peteattayek/PiTrac_V2/Hardware/firmware/START_HERE.md

# START HERE

Written for someone who has never built firmware for a Pico. No C knowledge
assumed. Follow it top to bottom; each step says what to expect so you can tell
whether it worked.

**Total time:** about 30–45 minutes for the first build, most of it downloads.

---

## What you're actually about to do

Four things, in order:

1. **Install a toolchain** — a compiler that turns `.c` files into a binary the
   RP2354 chip can run. Your PC's normal compiler makes Windows programs; this
   one makes ARM microcontroller programs.
2. **Build** — run the compiler. Produces `pitrac.uf2`, a single file.
3. **Flash** — copy that file onto the chip. The RP2354 has a trick where it
   pretends to be a USB memory stick, so "flashing" is literally drag-and-drop.
4. **Talk to it** — the firmware has a text menu over the USB cable. You open a
   terminal, type `stat`, and it answers.

Nothing here can damage the board. You're on USB power only, the +5 V rail is
off, and the firmware refuses to turn it on while running from USB.

---

## Step 1 — Install the toolchain

Use the VS Code extension. It downloads its own private copies of everything
into `C:\Users\<you>\.pico-sdk` and doesn't touch your system PATH, which on
Windows saves a great deal of pain.

1. Open **VS Code**.
2. Click the **Extensions** icon in the left sidebar (four little squares), or
   press `Ctrl+Shift+X`.
3. Search for **`Raspberry Pi Pico`**. Install the one published by
   **Raspberry Pi**. (Not "Pico-Go", not "Pymakr" — those are for MicroPython.)
4. After it installs, a small Raspberry Pi logo appears in the left sidebar.

> The extension downloads ~1–2 GB the first time it configures a project. That's
> normal and it only happens once.

---

## Step 2 — Open the project and let it configure

1. **File → Open Folder** → choose:
   ```
   C:\Users\ATTAYEKP\Github-Personal\PiTrac_V2\Hardware\firmware
   ```
   Open the **`firmware`** folder itself, not the folder above it. This matters —
   `CMakeLists.txt` has to be at the top level of what you open.

2. Press `Ctrl+Shift+P` to open the command palette (a text box at the top).
   Type **`Pico: Import Project`** and press Enter.

   > **⚠ It will look like it hangs. It hasn't.** The first thing this command
   > does is open a *native Windows folder picker*, and on Windows that dialog
   > very often opens **behind** the VS Code window. **Alt+Tab to find it.**
   > After the folder picker there is a second step: a **form in a new tab**
   > with an **Import button at the bottom that you have to scroll down to**.
   > Nothing downloads until you click it.

3. In that form:

   | Field | Choose |
   |---|---|
   | **ARM vs RISC-V** | **ARM.** Not negotiable — see below. |
   | **SDK version** | Newest offered, and it **must be ≥ 2.1**. Earlier SDKs don't know about the RP2354. |
   | **Board type** | Anything. `CMakeLists.txt` forces the real board and a compile-time assert catches any override. |
   | **Debugger** | Default is fine. Not used yet. |

   > **Why ARM matters:** the RP2350 die carries *both* dual Cortex-M33 (ARM)
   > and dual Hazard3 (RISC-V) cores, and the extension will cheerfully set you
   > up for RISC-V. All of this firmware assumes ARM, and the `.uf2` has to be
   > family `rp2350-arm-s`. Picking RISC-V produces confusing build failures.
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
