peteattayek/PiTrac_V2/Hardware/Calibration/index.html

# Camera distortion calibration

For each identified Mira220 / ND3630 stack at its final 850 nm filter, illumination and locked focus state.

Digital template validation is not physical calibration. Print at actual size / 100%, disable fit or shrink, and verify both 100 mm bars. Mount the target flat on rigid matte backing and check its actual infrared contrast.

## A4 landscape

297 x 210 mm page. Pattern: 220 x 160 mm.

Open printable A4 PDF | Open vector SVG

A4 ChArUco target with horizontal and vertical 100 mm scale checks

## US Letter landscape

279.4 x 215.9 mm page. Same physical pattern, not a resized A4 pattern.

Open printable Letter PDF | Open vector SVG

Letter ChArUco target with horizontal and vertical 100 mm scale checks

## Next steps

1. Read the entry guide and the calibration procedure.
2. Verify print dimensions, flatness and infrared contrast before filling a session record.
3. Copy the appropriate CAM0 or CAM1 session template to a new run directory.
4. Use the 30 fit / 10 validation pose checklist. Capture three distinct stationary frames per pose; keep repeat groups in the same split.
5. Preserve native 12-bit images and read the point-coordinate conventions.

Target identity: pitrac-charuco-11x8-20mm-v1, 11 x 8 squares, 20 mm square pitch, 15 mm markers, DICT_5X5_250, current (non-legacy) OpenCV 4.13 layout. Machine-readable board definition.

The images on this page are scaled for viewing. Measure the printed scale bars, not the screen. No camera coefficients, pupil coordinate, enclosure pose, physical accuracy, or production readiness are established by these files.
