peteattayek/PiTrac_V2/Hardware/Calibration/targets/charuco-a4.pdf

pitrac-charuco-11x8-20mm-v1 | 20 mm squares | 15 mm markers | PRINT 100%

100 mm X

100 mm Y
