peteattayek/PiTrac_V2/Hardware/Calibration/targets/board-raster.png

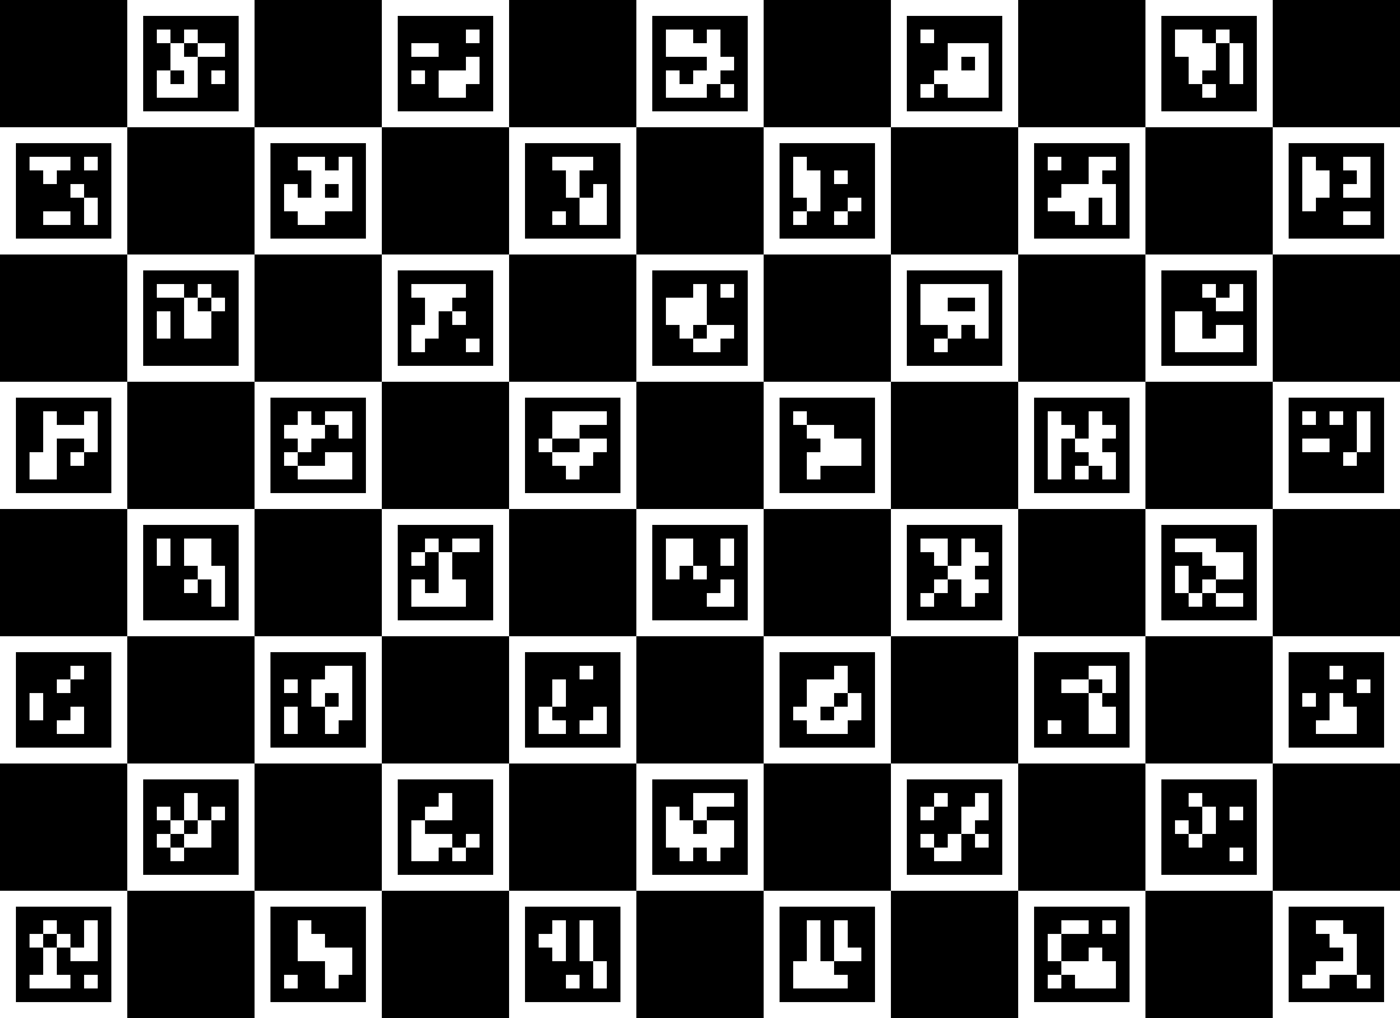
Hardware/Calibration/targets/board-raster.png
