peteattayek/PiTrac_V2/Hardware/The_Second_Board_To_Rule_Them_All/The_Second_Board_To_Rule_Them_All.pdf

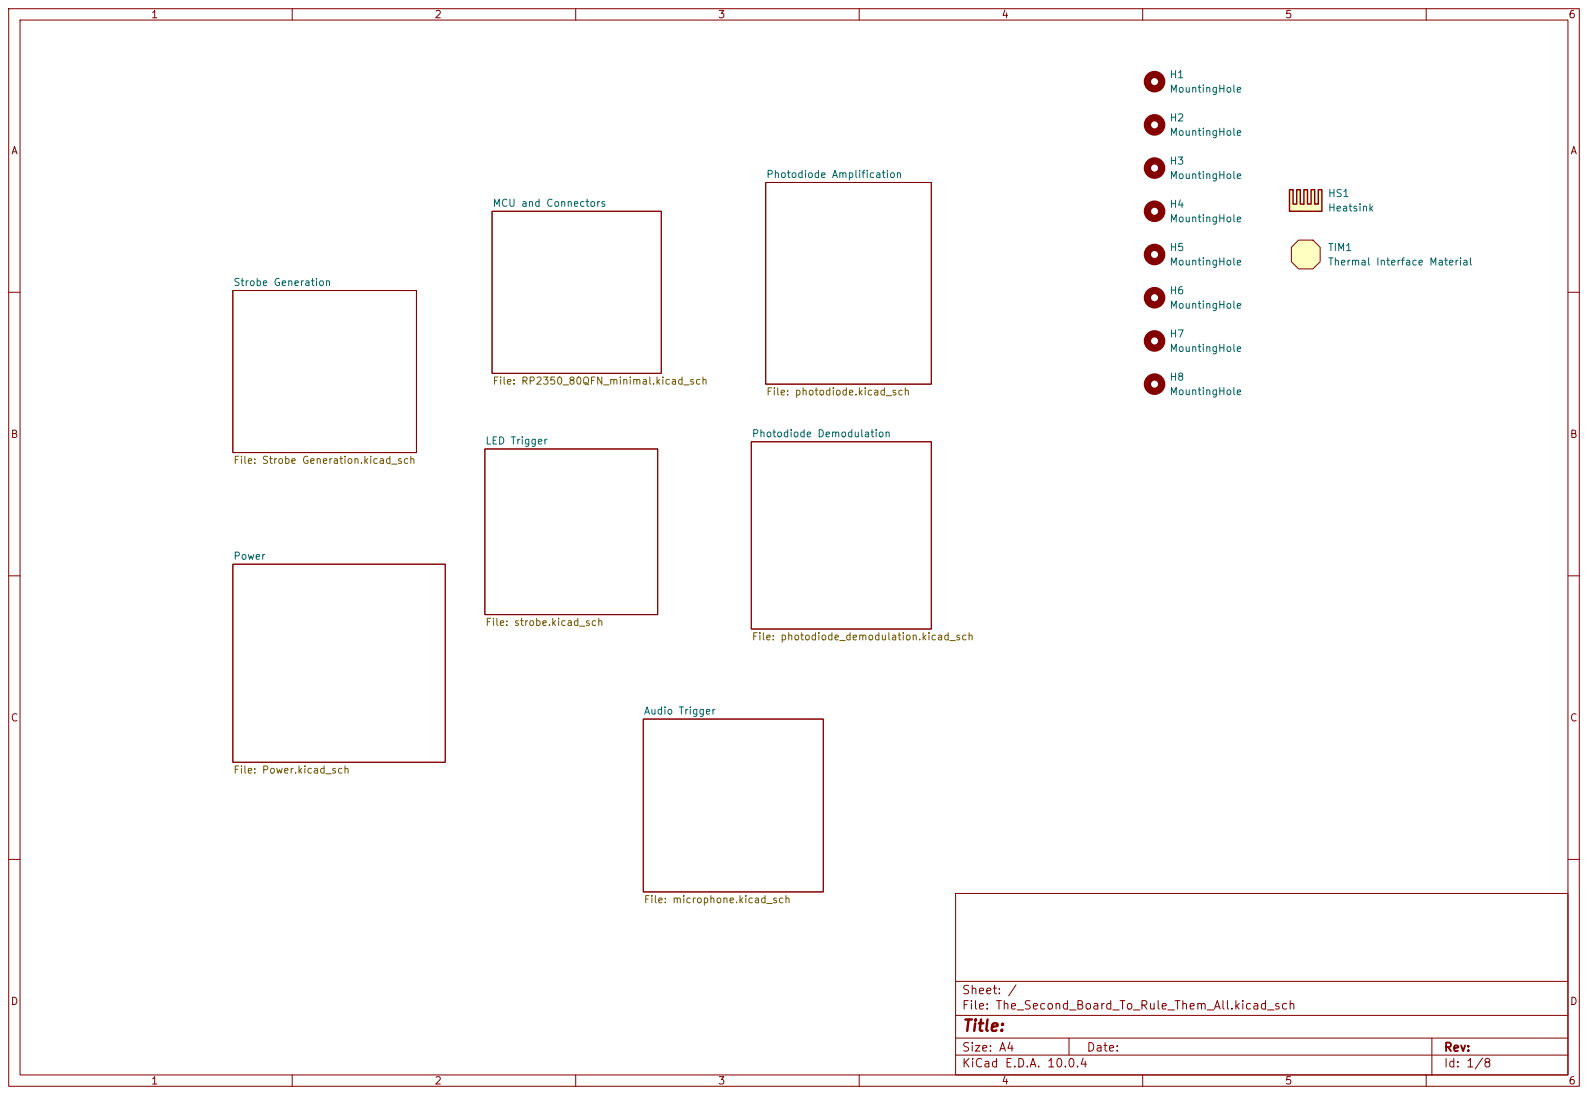
[picture p2: page 1]

Thermal Interface Material HS1 Heatsink H8MountingHole H7MountingHole H6MountingHole

LED Trigger File: strobe.kicad_sch Strobe Generation

Audio Trigger File: microphone.kicad_sch

Size: A4 | Rev:
KiCad E.D.A. 10.0.4 | Id: 1/8

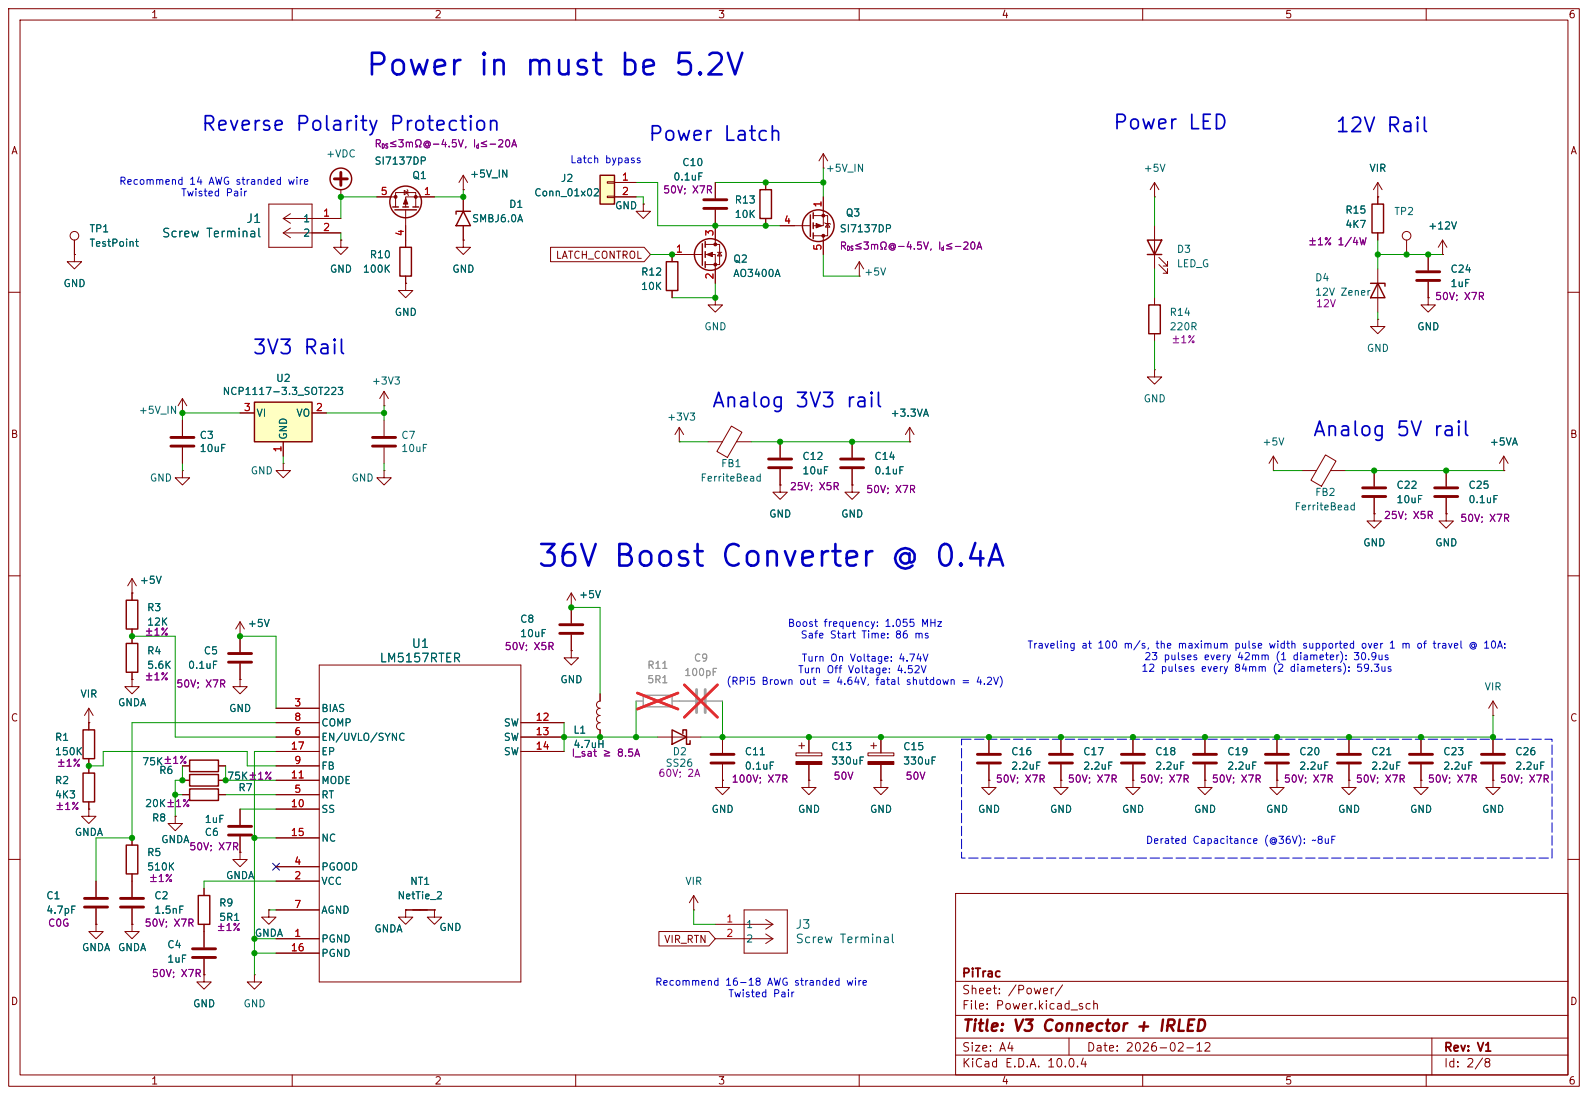
[picture p3: page 2]

J2 Conn_01x02 R3
Recommend 14 AWG stranded wire

Derated Capacitance (@36V): ~8uF Boost frequency: 1.055 MHz Safe Start Time: 86 ms

(RPi5 Brown out = 4.64V, fatal shutdown = 4.2V)

Recommend 16-18 AWG stranded wire

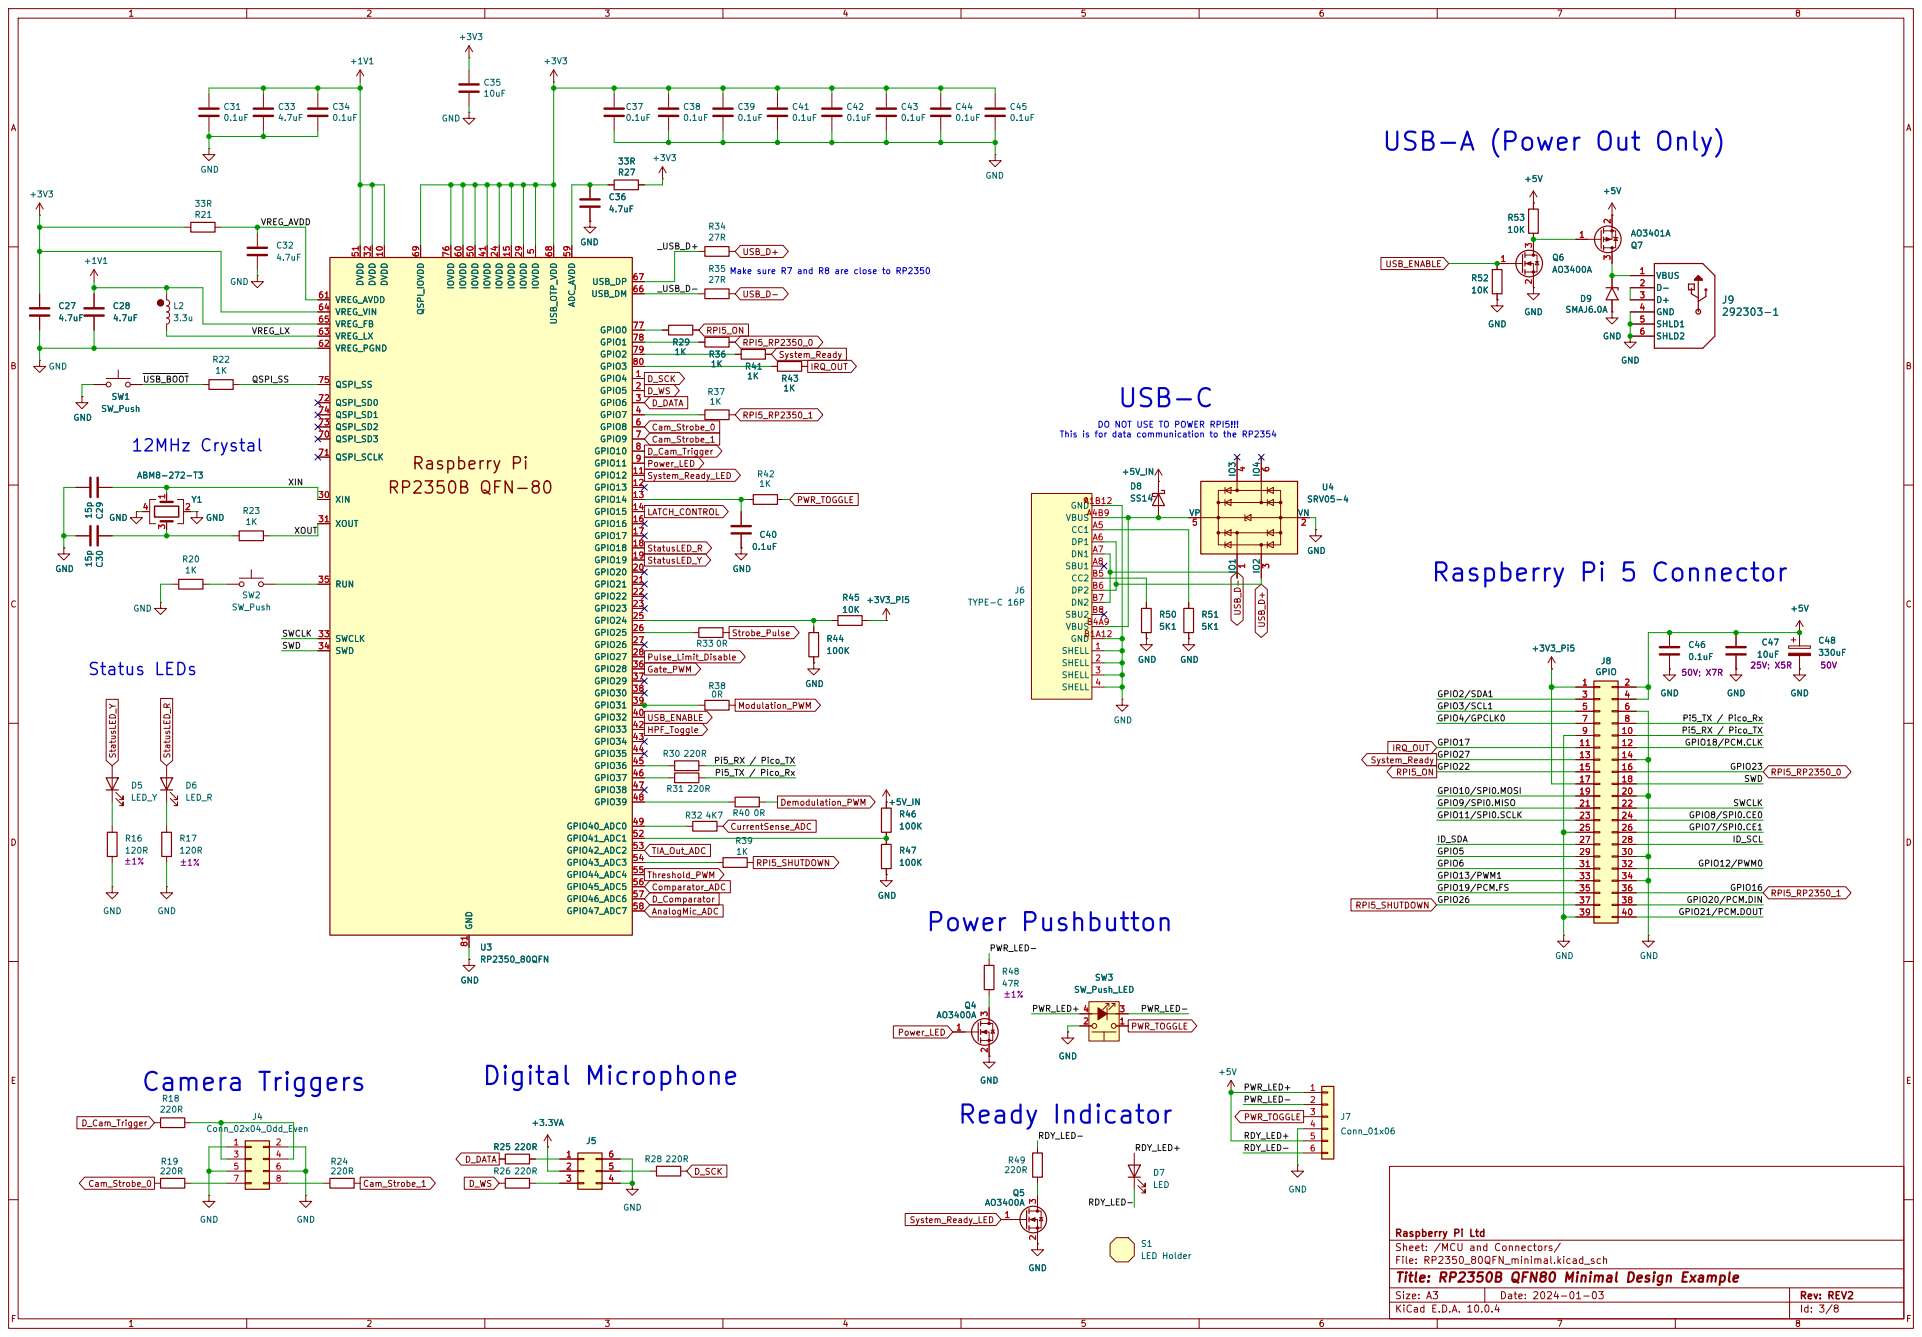
[picture p4: page 3]

USB-A (Power Out Only)

5 GPIO8 6 GPIO9 7 GPIO10 8 GPIO11 9 DVDD 10 GPIO12 11 GPIO13 12 GPIO14 13 GPIO15 14 IOVDD 15 GPIO16 16 GPIO17 17 GPIO18 18 GPIO19 19 GPIO20 20 GPIO21 21 GPIO22 22 GPIO23 23 IOVDD 24 GPIO24 25 GPIO25 26 GPIO26 27 GPIO27 28 IOVDD 29

Raspberry Pi Ltd
Sheet: /MCU and Connectors/
File: RP2350_80QFN_minimal.kicad_sch
Title: RP2350B QFN80 Minimal Design Example

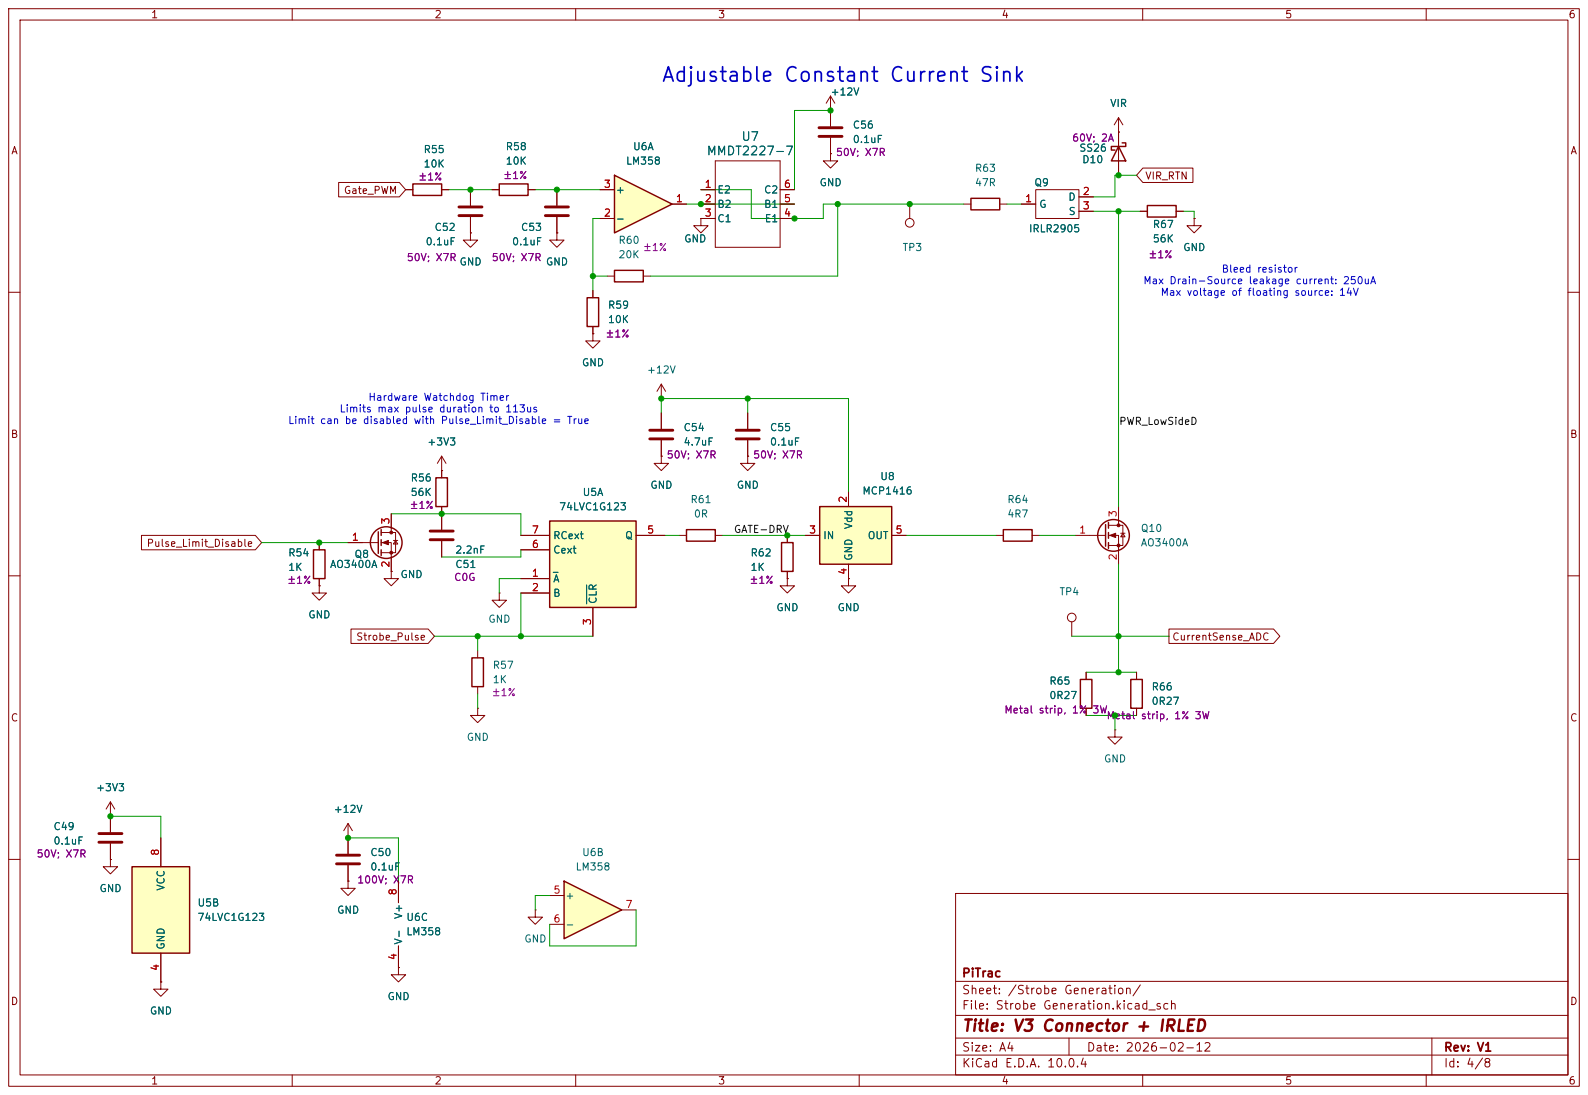
[picture p5: page 4]

GATE-DRV Adjustable Constant Current Sink

GND Q8 AO3400A 1
Bleed resistor Max Drain-Source leakage current: 250uA Max voltage of floating source: 14V Hardware Watchdog Timer Limits max pulse duration to 113us

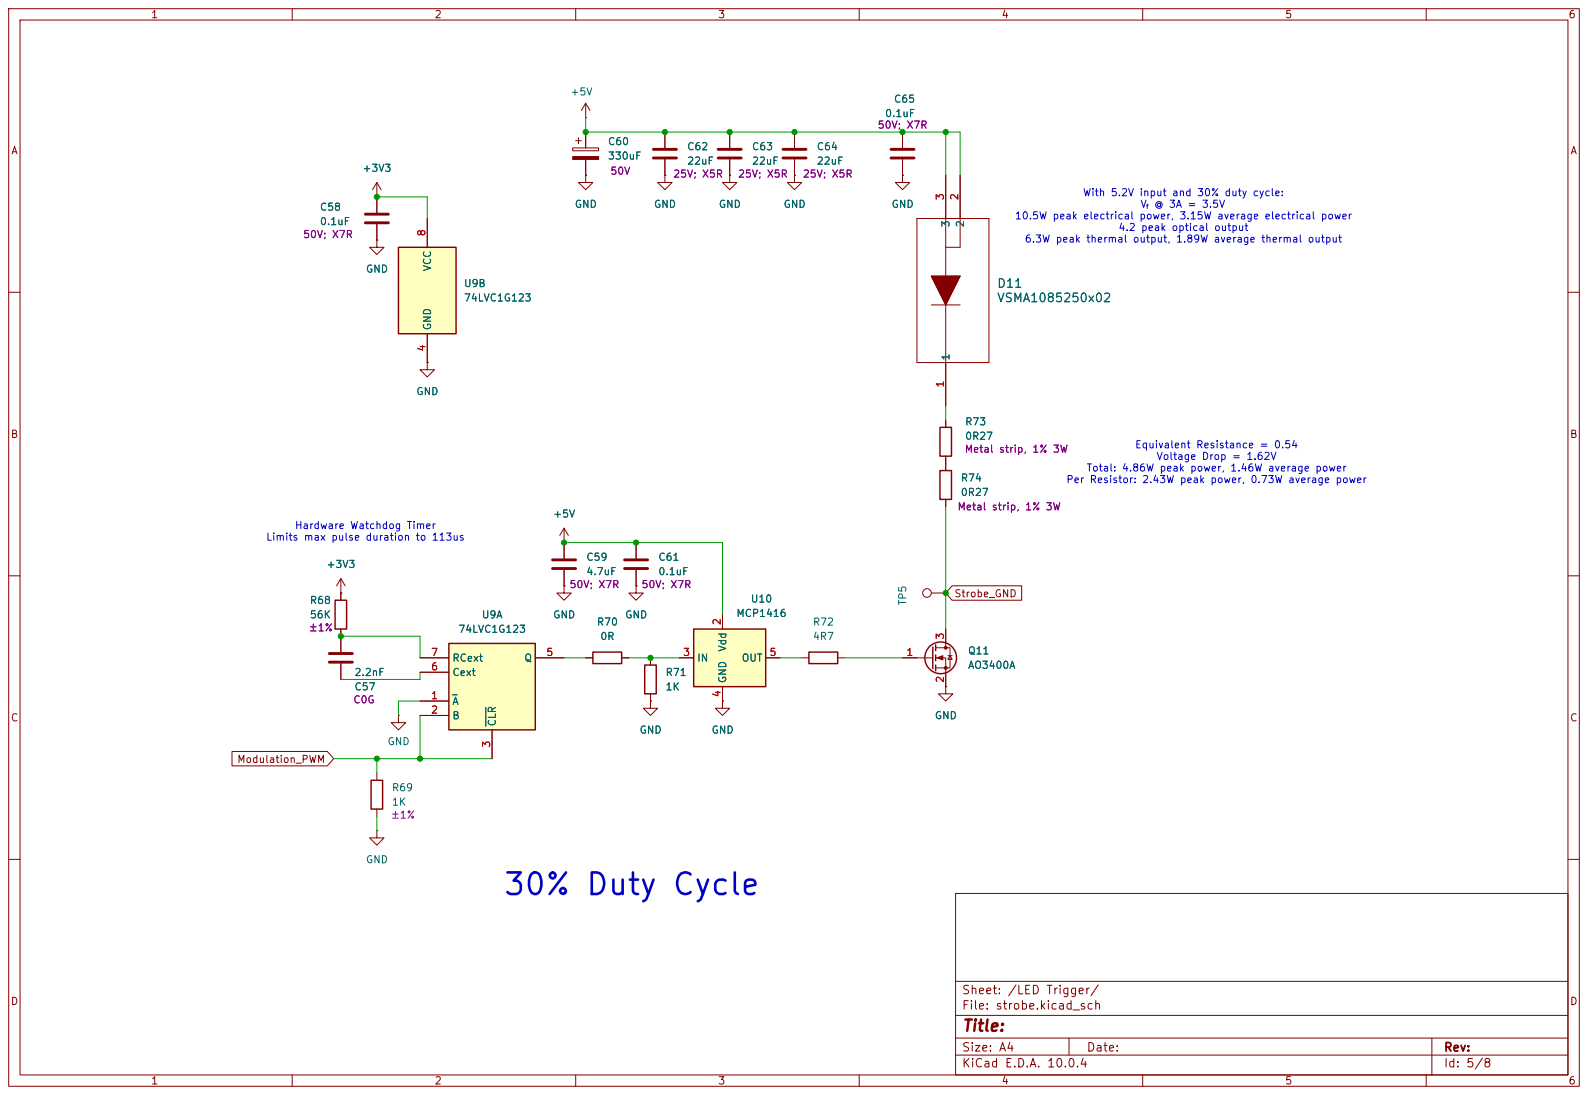
[picture p6: page 5]

Total: 4.86W peak power, 1.46W average power Per Resistor: 2.43W peak power, 0.73W average power C59

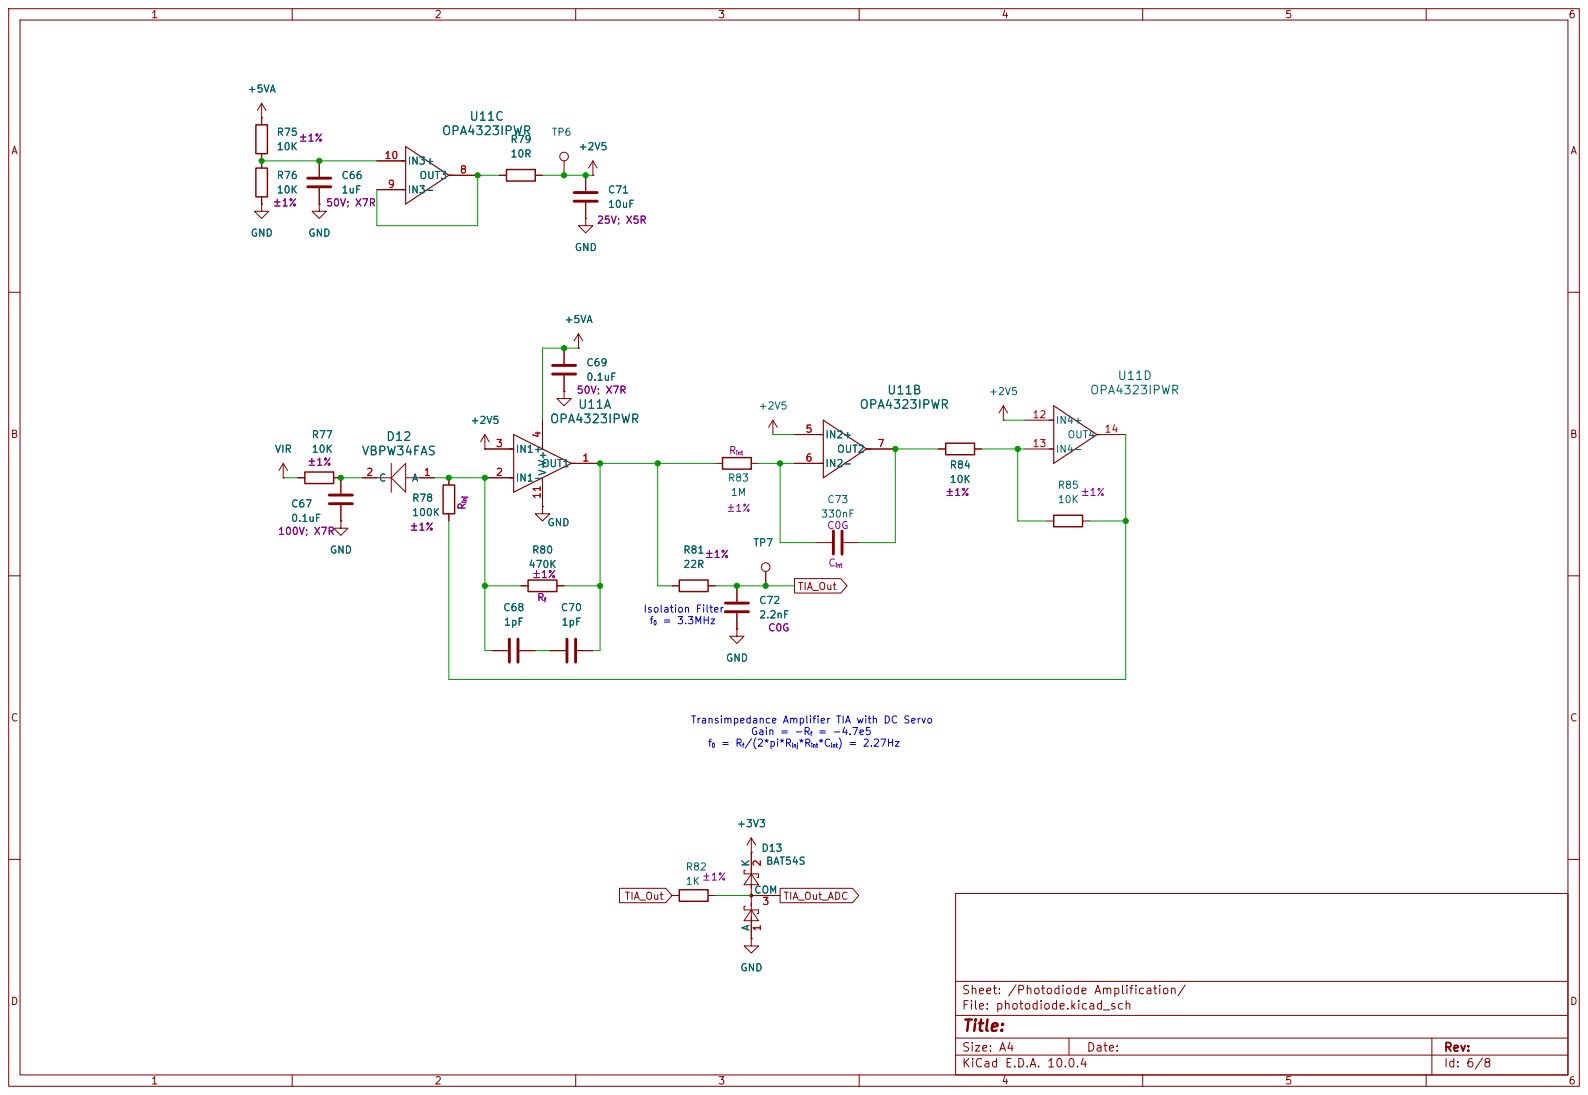
[picture p7: page 6]

f0 = Rf/(2*pi*Rinj*Rint*Cint) = 2.27Hz U11C
OPA4323IPWR R79

Transimpedance Amplifier TIA with DC Servo Gain = -Rf = -4.7e5

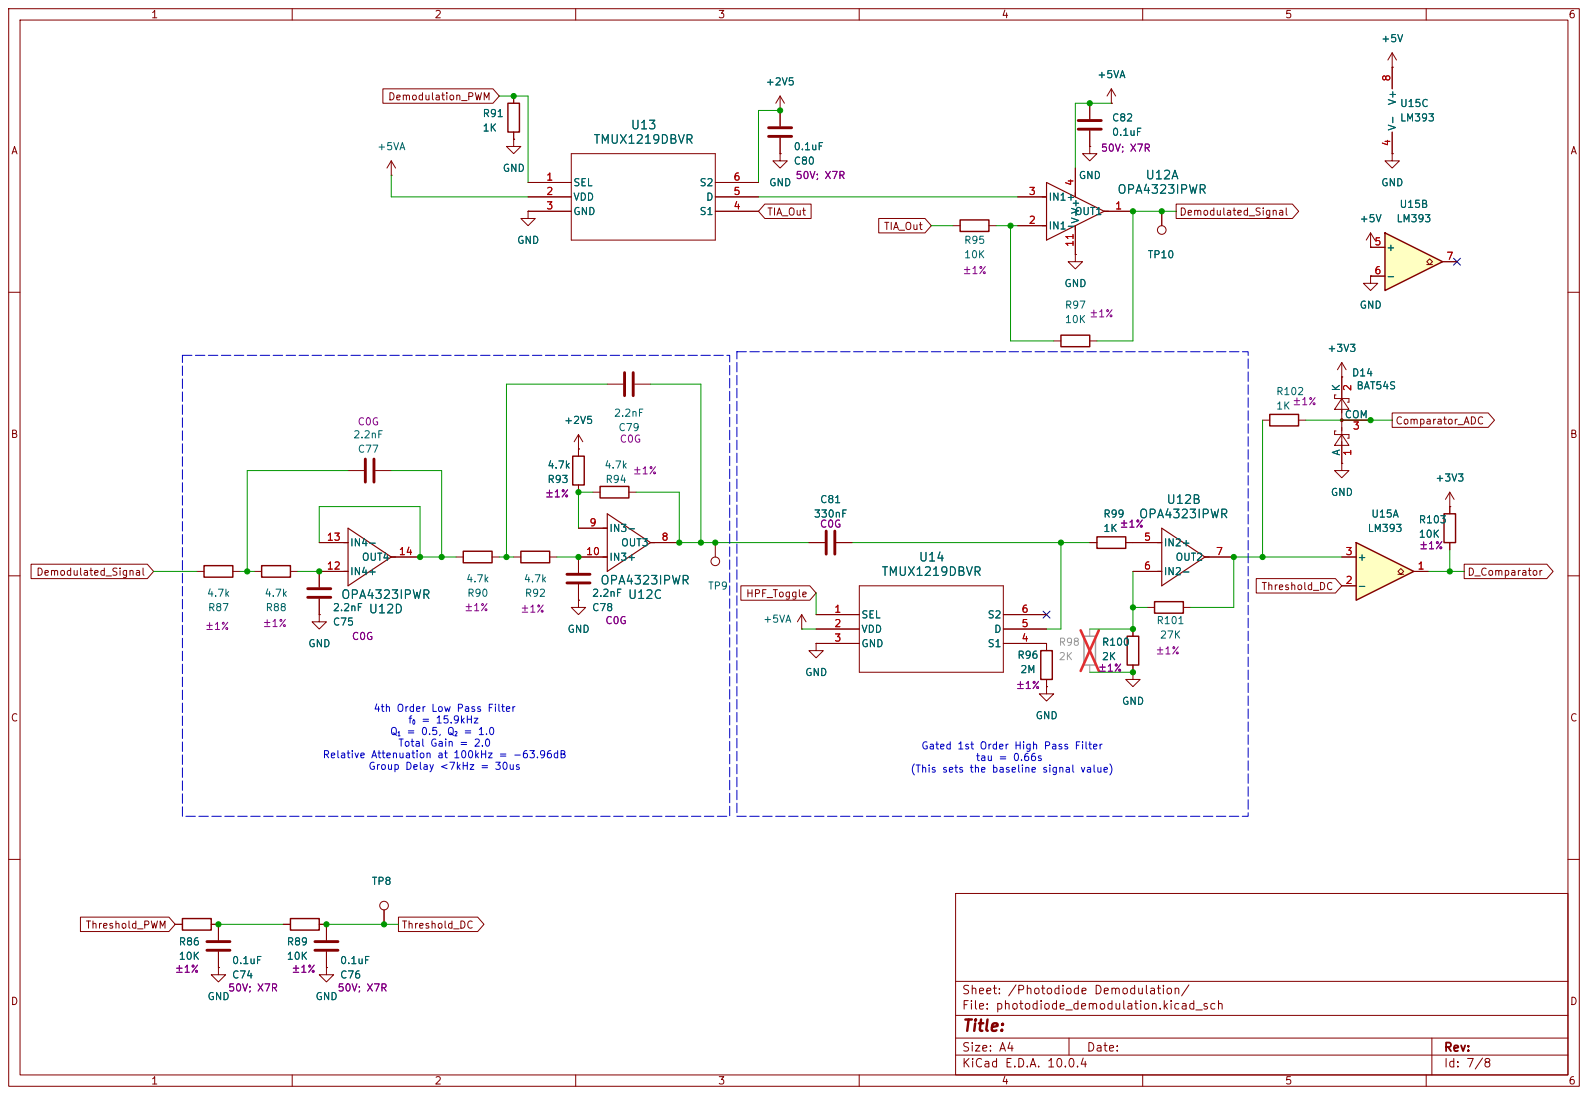
[picture p8: page 7]

(This sets the baseline signal value) 4th Order Low Pass Filter
f0 = 15.9kHz Q1 = 0.5, Q2 = 1.0

Total Gain = 2.0 Relative Attenuation at 100kHz = -63.96dB

Gated 1st Order High Pass Filter

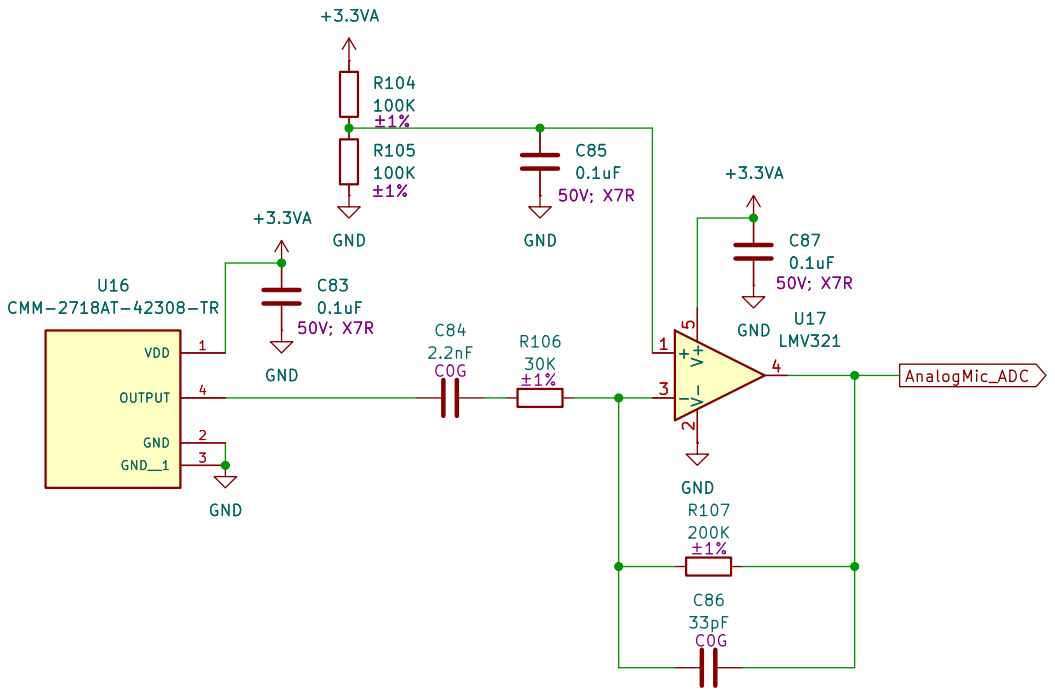
[picture p9: page 8]
