peteattayek/PiTrac_V2/Hardware/The_Second_Board_To_Rule_Them_All/The_Second_Board_To_Rule_Them_All.kicad_pcb

## KiCad design Hardware/The_Second_Board_To_Rule_Them_All/The_Second_Board_To_Rule_Them_All.kicad_pcb (2026-07-31)

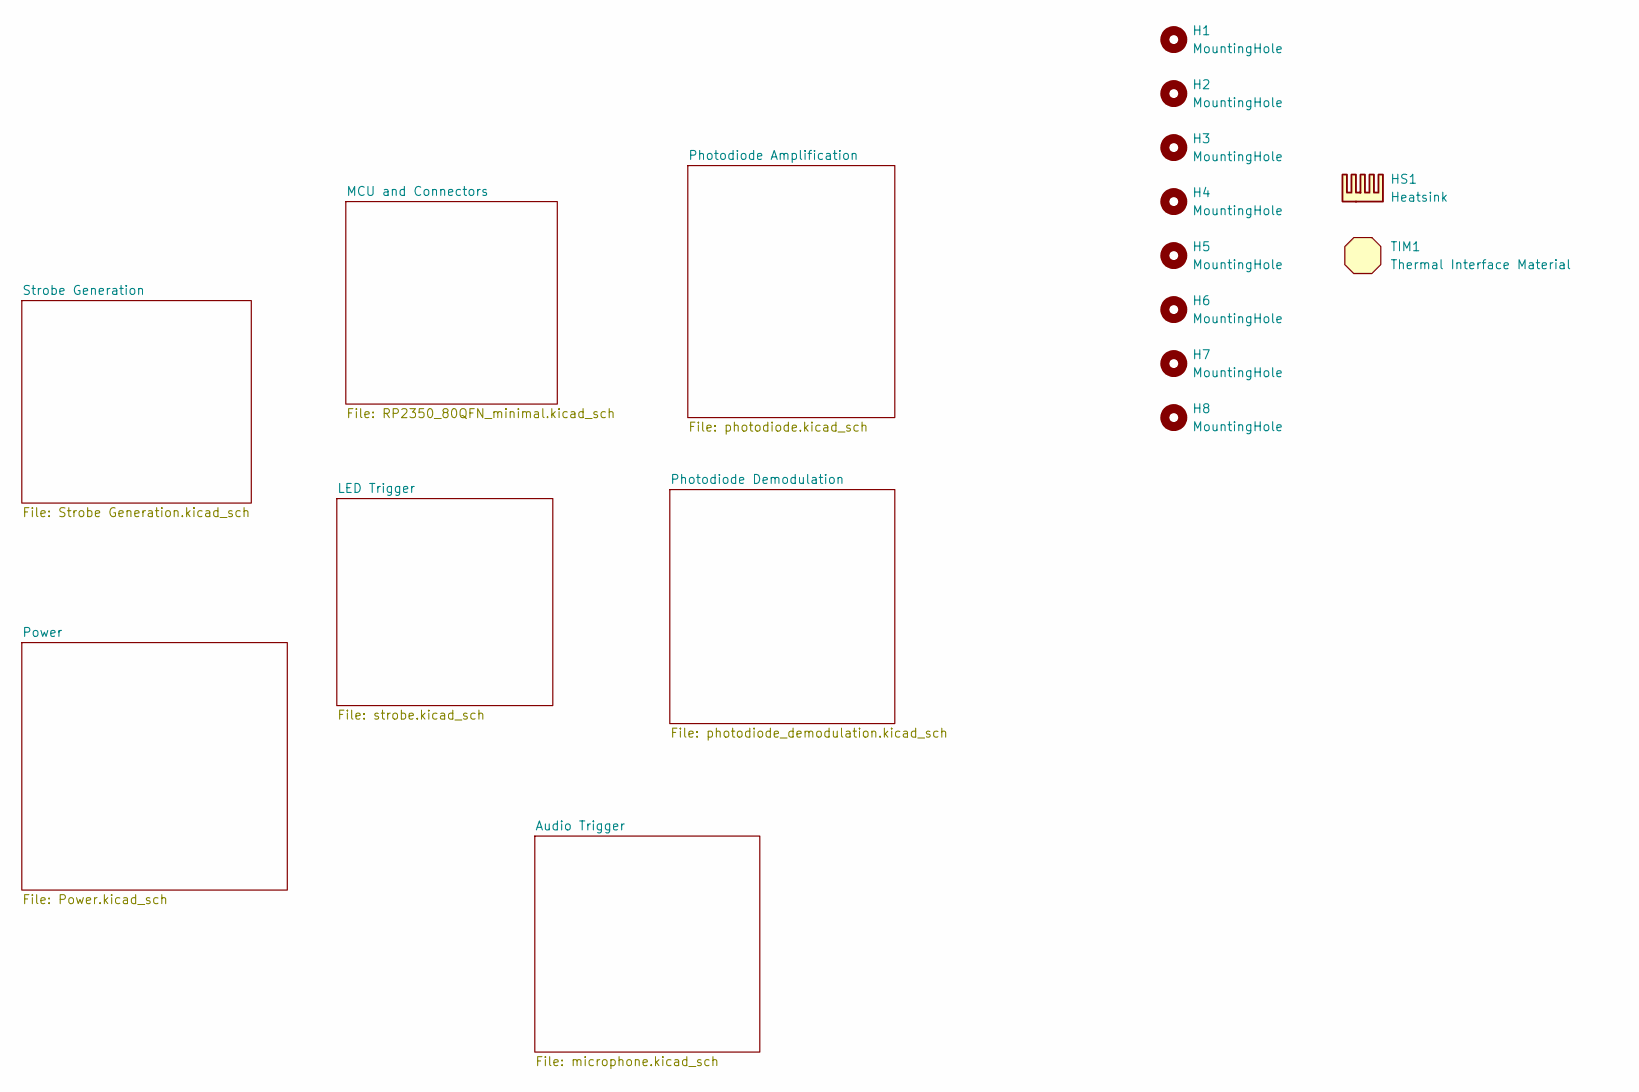
[picture p10: schematic The_Second_Board_To_Rule_Them_All.kicad_sch]

Parts:
H1, H2, H7, H8: MountingHole; MountingHole_2.2mm_M2
H3, H4, H5, H6: MountingHole; MountingHole_2.7mm_M2.5
HS1: Heatsink; Ratings <= 27 C/W; MPN HSB09-212115
TIM1: Thermal Interface Material; MPN TG-T1000-20-20-0.25-5PT

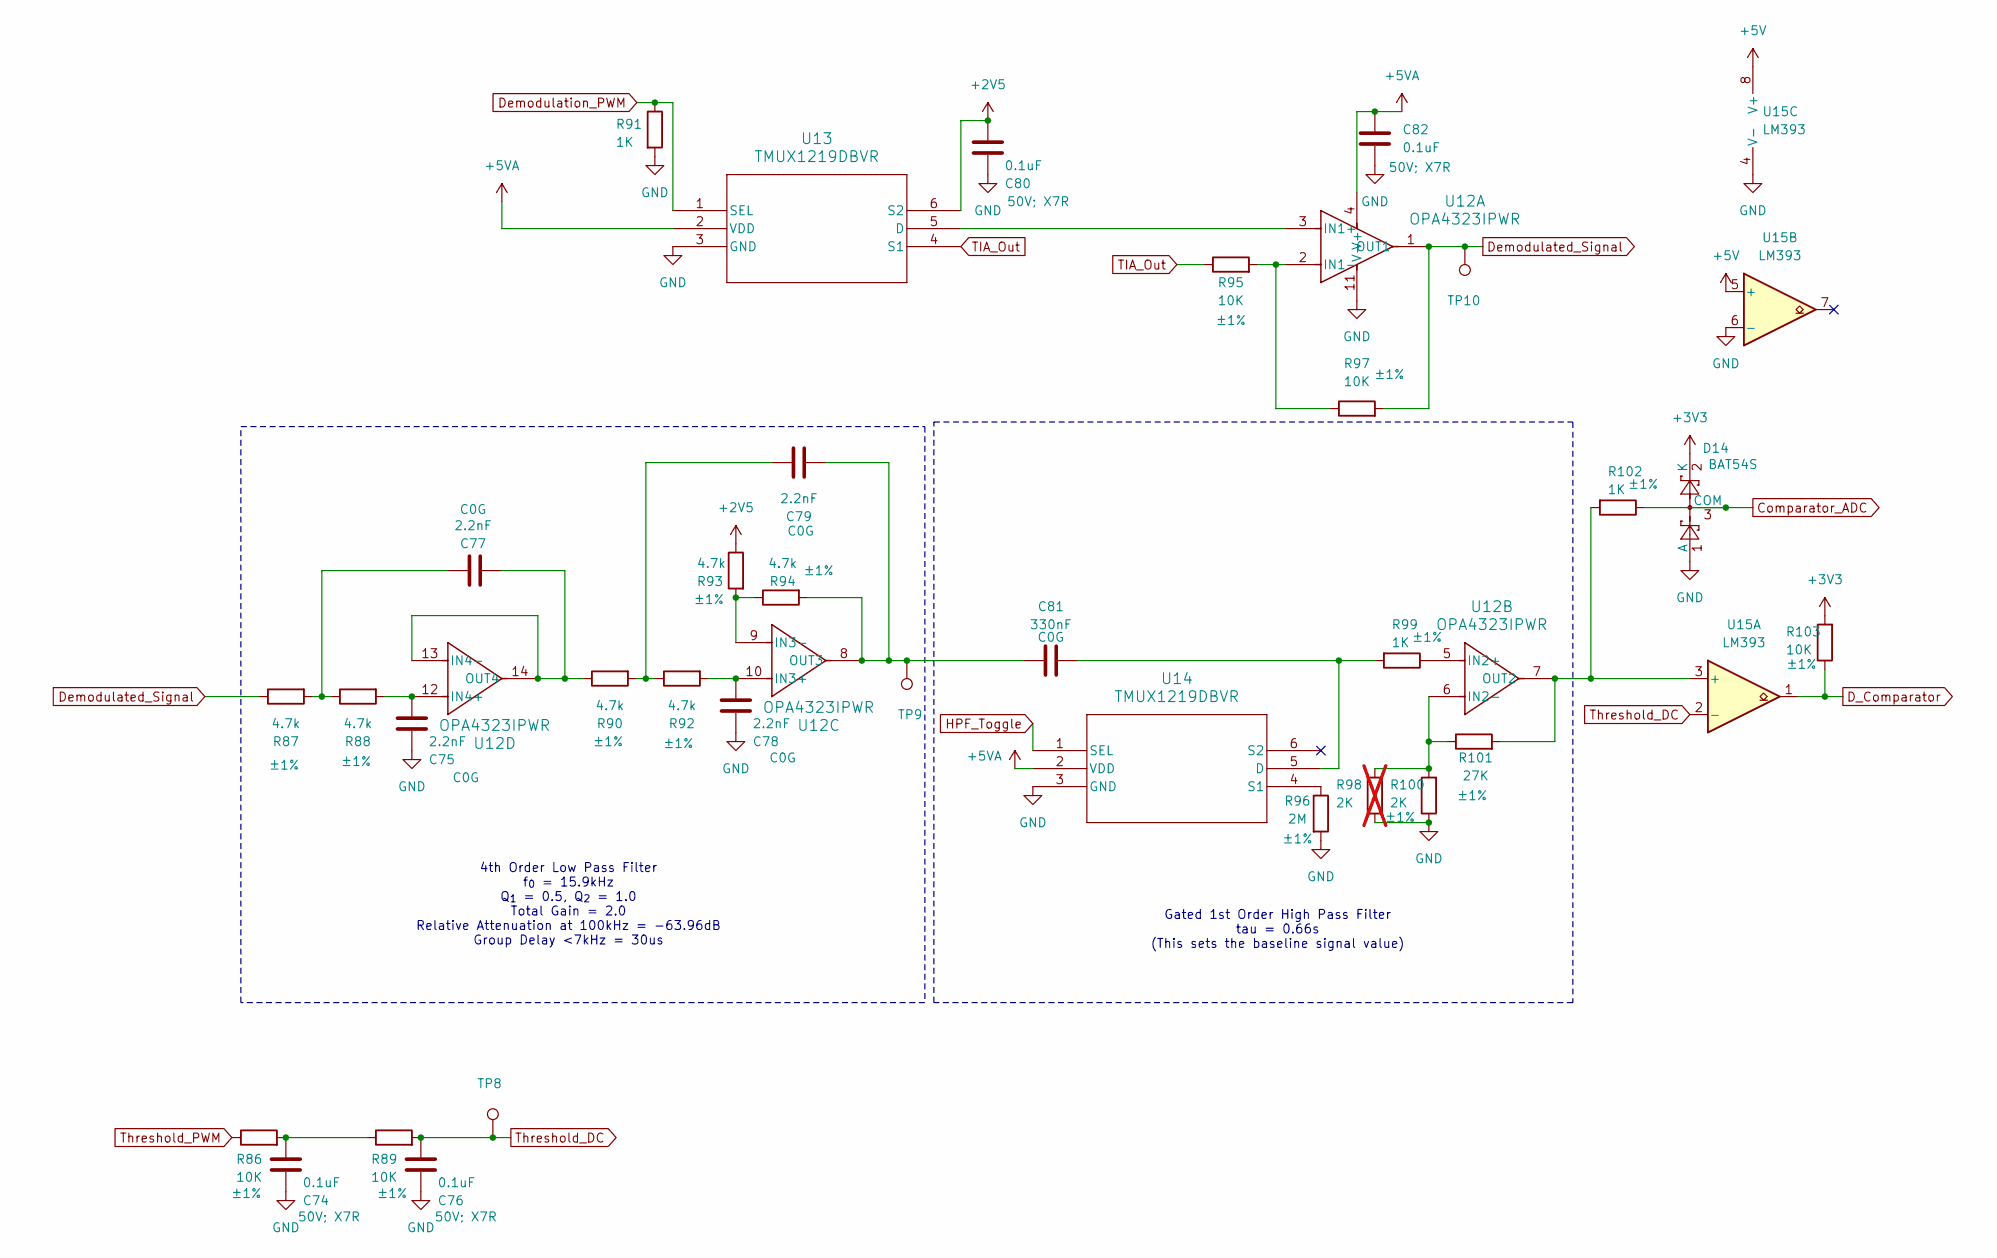
[picture p11: schematic photodiode_demodulation.kicad_sch]

Parts:
C74, C76, C80, C82: 0.1uF; C_0402_1005Metric; Ratings 50V; X7R; MPN CL05B104KB54PNC; LCSC C307331
C75, C77, C78, C79: 2.2nF; C_0805_2012Metric; Ratings C0G; MPN CL21C222JBFNNNE; LCSC C28260
C81: 330nF; C_1206_3216Metric; Ratings C0G; MPN GRM31C5C1E334JE01L; LCSC C3837965
D14: BAT54S; SOT-23; MPN BAT54SLT1G; LCSC C7420333
R86, R89, R95, R97, R103: 10K; R_0402_1005Metric; Ratings ±1%; MPN RMCF0402FT10K0; LCSC C25744
R87, R88, R90, R92, R93, R94: 4.7k; R_0402_1005Metric; Ratings ±1%; MPN RMCF0402FT4K70; LCSC C25900
R91, R99, R102: 1K; R_0402_1005Metric; Ratings ±1%; MPN RMCF0402FT1K00; LCSC C11702
R96: 2M; R_0603_1608Metric; Ratings ±1%; MPN RMCF0603FT2M00; LCSC C22976
R98: 2K; R_0805_2012Metric_Pad1.20x1.40mm_HandSolder; Ratings ±1%; MPN RMCF0805FT2K00; not fitted
R100: 2K; R_0805_2012Metric_Pad1.20x1.40mm_HandSolder; Ratings ±1%; MPN RMCF0805FT2K00; LCSC C17604
R101: 27K; R_0402_1005Metric; Ratings ±1%; MPN RMCF0402FT27K0; LCSC C25771
TP8, TP9, TP10: TestPoint; TestPoint_THTPad_D1.0mm_Drill0.5mm
U12: OPA4323IPWR; PW0014A-IPC_A; MPN OPA4323IPWR; LCSC C22419728
U13, U14: TMUX1219DBVR; SOT-23-6_DBV_TEX; MPN TMUX1219DBVR; LCSC C2869838
U15: LM393; SOIC-8_3.9x4.9mm_P1.27mm; MPN LM393DR2G; Digikey PN LM393DR2GOSCT-ND

Connections:
+2V5: C80.2, R93.1, U13.6 (S2); also elsewhere on the board
+3V3: D14.2 (K), R103.2; also elsewhere on the board
+5V: U15.5 (+), U15.8 (V+); also elsewhere on the board
+5VA: C82.1, U12.4 (V+), U13.2 (VDD), U14.2 (VDD); also elsewhere on the board
Comparator_ADC: D14.3 (COM), R102.1; also elsewhere on the board
D_Comparator: R103.1, U15.1; also elsewhere on the board
Demodulated_Signal: R87.1, R97.2, TP10.1 (1_1), U12.1 (OUT1)
Demodulation_PWM: R91.1, U13.1 (SEL); also elsewhere on the board
GND: C74.1, C75.1, C76.1, C78.1, C80.1, C82.2, D14.1 (A), R91.2, R96.2, R98.1, R100.1, U12.11 (V-), U13.3 (GND), U14.3 (GND), U15.4 (V-), U15.6 (-); also elsewhere on the board
HPF_Toggle: U14.1 (SEL); also elsewhere on the board
unnamed: C74.2, R86.2, R89.1
unnamed: C77.1, R87.2, R88.1
unnamed: C79.1, R90.2, R92.1
unnamed: U12.3 (IN1+), U13.5 (D)
unnamed: R95.2, R97.1, U12.2 (IN1-)
unnamed: R99.1, U12.5 (IN2+)
unnamed: R98.2, R100.2, R101.1, U12.6 (IN2-)
unnamed: R101.2, R102.2, U12.7 (OUT2), U15.3 (+)
unnamed: C78.2, R92.2, U12.10 (IN3+)
unnamed: R93.2, R94.1, U12.9 (IN3-)
unnamed: C79.2, C81.1, R94.2, TP9.1 (1_1), U12.8 (OUT3)
unnamed: C75.2, R88.2, U12.12 (IN4+)
unnamed: C77.2, R90.1, U12.13 (IN4-), U12.14 (OUT4)
unnamed: C81.2, R99.2, U14.5 (D)
unnamed: R96.1, U14.4 (S1)
TIA_Out: R95.1, U13.4 (S1); also elsewhere on the board
Threshold_DC: C76.2, R89.2, TP8.1 (1_1), U15.2 (-)
Threshold_PWM: R86.1; also elsewhere on the board

Notes on the sheet:
Gated 1st Order High Pass Filter tau = 0.66s (This sets the baseline signal value)
4th Order Low Pass Filter f_{0} = 15.9kHz Q_{1} = 0.5, Q_{2} = 1.0 Total Gain = 2.0 Relative Attenuation at 100kHz = -63.96dB Group Delay <7kHz = 30us

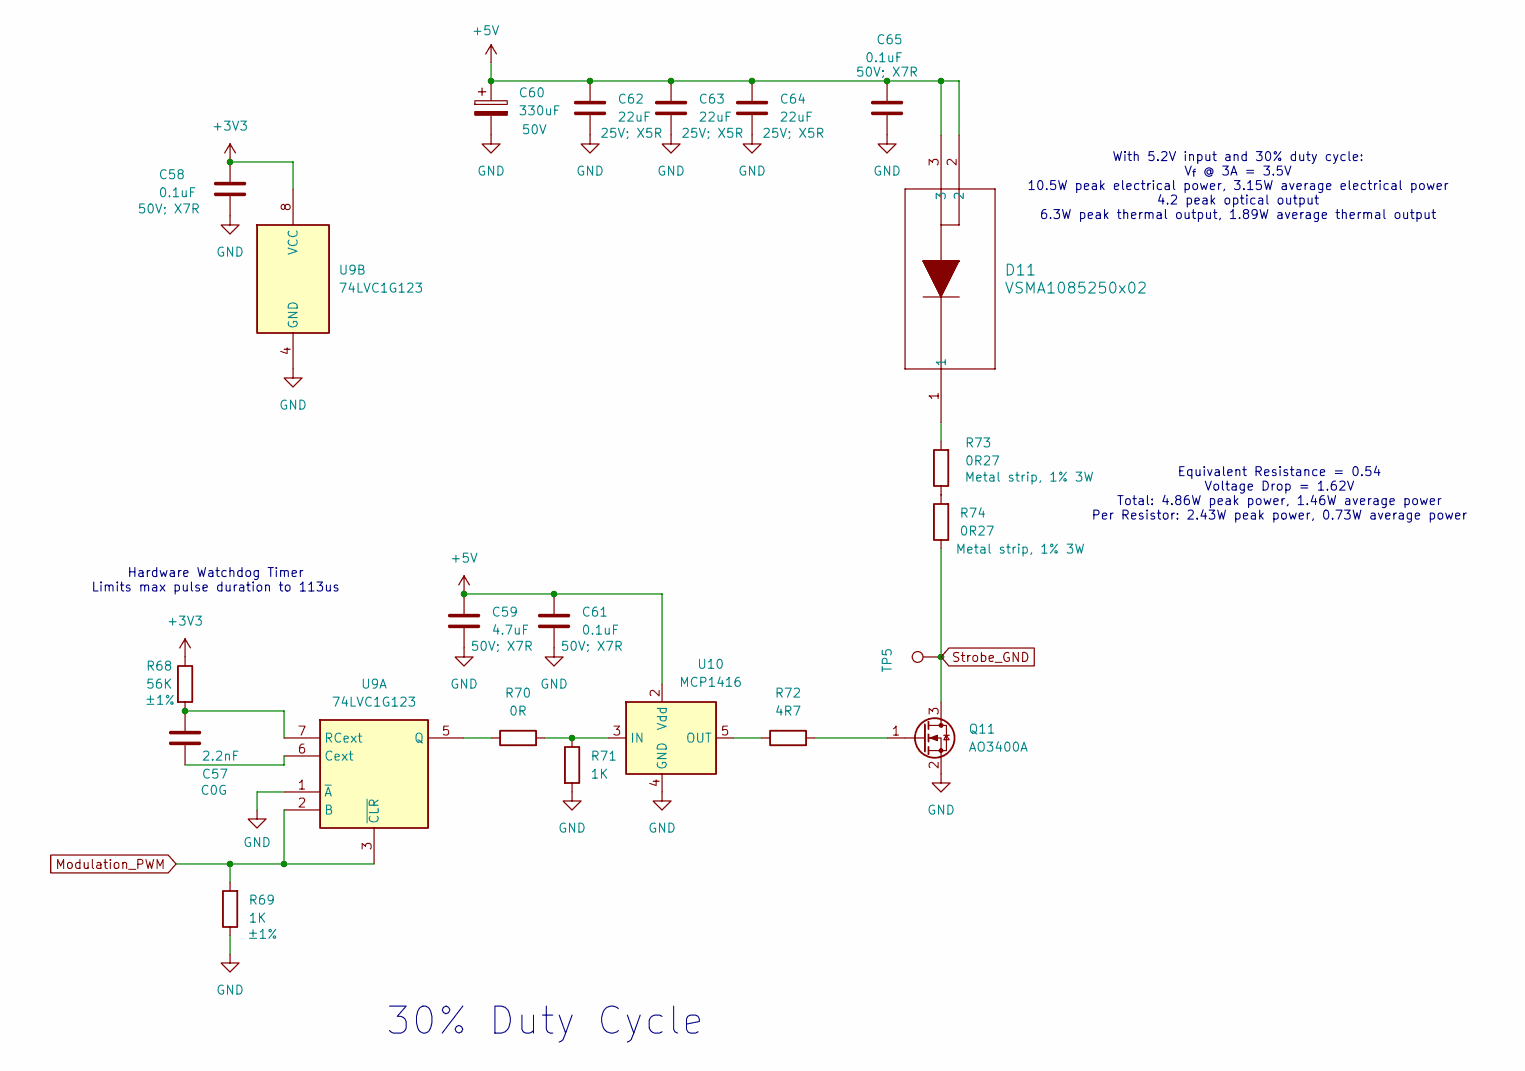
[picture p12: schematic strobe.kicad_sch]

Parts:
C57: 2.2nF; C_0805_2012Metric; Ratings C0G; MPN CL21C222JBFNNNE; LCSC C28260
C58, C61, C65: 0.1uF; C_0402_1005Metric; Ratings 50V; X7R; MPN CL05B104KB54PNC; LCSC C307331
C59: 4.7uF; C_1206_3216Metric; Ratings 50V; X7R; MPN CL31B475KBHNFNE; LCSC C29823
C60: 330uF; CAP_50TPV_10x10.5_RBY; Ratings 50V; MPN 50TPV330M10X10.5; LCSC C53120968
C62, C63, C64: 22uF; C_1206_3216Metric; Ratings 25V; X5R; MPN CL31A226KAHNNNE; LCSC C12891
D11: VSMA1085250x02; DIODE_VSMA1085250_VIS; MPN VSMA1085250X02; LCSC C20346087
Q11: AO3400A; SOT-23; MPN AO3400A; Digikey PN 785-1000-1-ND
R68: 56K; R_0603_1608Metric; Ratings ±1%; MPN RMCF0603FT56K0; LCSC C23206
R69, R71: 1K; R_0402_1005Metric; Ratings ±1%; MPN RMCF0402FT1K00; LCSC C11702
R70: 0R; R_0805_2012Metric_Pad1.20x1.40mm_HandSolder; MPN RMCF0805ZT0R00; LCSC C17477
R72: 4R7; R_0805_2012Metric; Ratings ±1%; MPN RMCF0805FT4R70; LCSC C17675
R73, R74: 0R27; R_2512_6332Metric; Ratings Metal strip, 1% 3W; MPN HoJLR2512-3W-270mR-1%; LCSC C2903472
TP5: TestPoint; TestPoint_THTPad_D1.0mm_Drill0.5mm
U9: 74LVC1G123; VSSOP-8_2.3x2mm_P0.5mm; MPN SN74LVC1G123DCUR; LCSC C26159250
U10: MCP1416; SOT-23-5; MPN MCP1416T-E/OT; LCSC C83775

Connections:
+3V3: C58.1, R68.1, U9.8 (VCC); also elsewhere on the board
+5V: C59.1, C60.1, C61.1, C62.1, C63.1, C64.1, C65.2, D11.2, D11.3, U10.2 (Vdd); also elsewhere on the board
GND: C58.2, C59.2, C60.2, C61.2, C62.2, C63.2, C64.2, C65.1, Q11.2 (S), R69.1, R71.2, U9.1 (~A), U9.4 (GND), U10.4 (GND); also elsewhere on the board
Modulation_PWM: R69.2, U9.2 (B), U9.3 (~CLR); also elsewhere on the board
unnamed: D11.1, R73.2
unnamed: Q11.1 (G), R72.2
unnamed: R73.1, R74.2
unnamed: C57.1, U9.6 (Cext)
unnamed: R70.1, U9.5 (Q)
unnamed: C57.2, R68.2, U9.7 (RCext)
unnamed: R70.2, R71.1, U10.3 (IN)
unnamed: R72.1, U10.5 (OUT)
Strobe_GND: Q11.3 (D), R74.1, TP5.1 (1_1)

Notes on the sheet:
Hardware Watchdog Timer Limits max pulse duration to 113us
30% Duty Cycle
With 5.2V input and 30% duty cycle: V_{f} @ 3A = 3.5V 10.5W peak electrical power, 3.15W average electrical power 4.2 peak optical output 6.3W peak thermal output, 1.89W average thermal output
Equivalent Resistance = 0.54 Voltage Drop = 1.62V Total: 4.86W peak power, 1.46W average power Per Resistor: 2.43W peak power, 0.73W average power

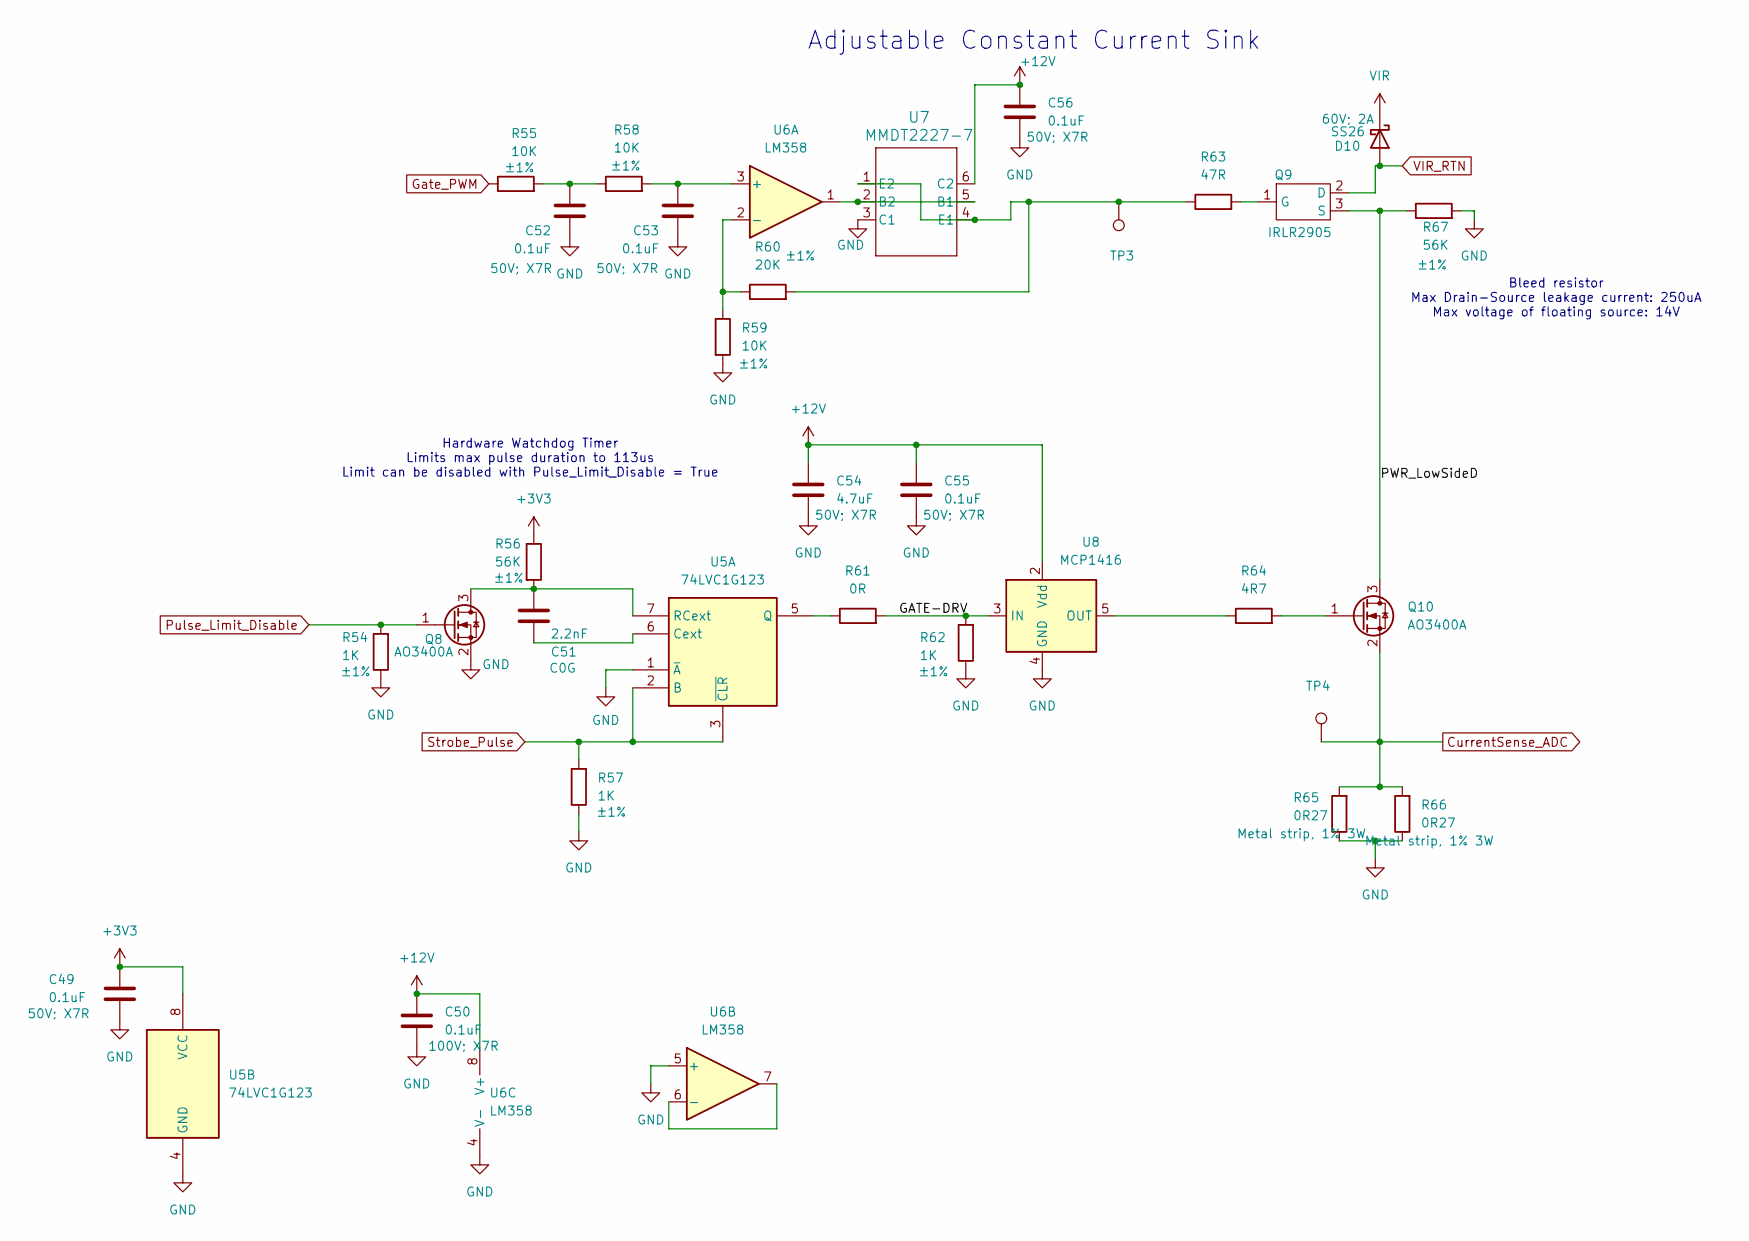
[picture p13: schematic Strobe Generation.kicad_sch, V3 Connector + IRLED]

Parts:
C49, C52, C53, C55, C56: 0.1uF; C_0402_1005Metric; Ratings 50V; X7R; MPN CL05B104KB54PNC; LCSC C307331
C50: 0.1uF; C_0805_2012Metric; Ratings 100V; X7R; MPN CL21B104KCFNNNE; LCSC C28233
C51: 2.2nF; C_0805_2012Metric; Ratings C0G; MPN CL21C222JBFNNNE; LCSC C28260
C54: 4.7uF; C_1206_3216Metric; Ratings 50V; X7R; MPN CL31B475KBHNFNE; LCSC C29823
D10: SS26; D_SMA; Ratings 60V; 2A; MPN SS26S-E3/5AT; LCSC C7420363
Q8, Q10: AO3400A; SOT-23; MPN AO3400A; Digikey PN 785-1000-1-ND
Q9: IRLR2905; ThermalVias; MPN IRLR2905TRPBF; LCSC C3010
R54, R57, R62: 1K; R_0402_1005Metric; Ratings ±1%; MPN RMCF0402FT1K00; LCSC C11702
R55, R58, R59: 10K; R_0402_1005Metric; Ratings ±1%; MPN RMCF0402FT10K0; LCSC C25744
R56, R67: 56K; R_0603_1608Metric; Ratings ±1%; MPN RMCF0603FT56K0; LCSC C23206
R60: 20K; R_0402_1005Metric; Ratings ±1%; MPN RMCF0402FT20K0; LCSC C25765
R61: 0R; R_0805_2012Metric_Pad1.20x1.40mm_HandSolder; MPN RMCF0805ZT0R00; LCSC C17477
R63: 47R; R_0402_1005Metric; Ratings ±1%; MPN RMCF0402FT47R0; LCSC C25118
R64: 4R7; R_0805_2012Metric; Ratings ±1%; MPN RMCF0805FT4R70; LCSC C17675
R65, R66: 0R27; R_2512_6332Metric; Ratings Metal strip, 1% 3W; MPN HoJLR2512-3W-270mR-1%; LCSC C2903472
TP3, TP4: TestPoint; TestPoint_THTPad_D1.0mm_Drill0.5mm
U5: 74LVC1G123; VSSOP-8_2.3x2mm_P0.5mm; MPN SN74LVC1G123DCUR; LCSC C26159250
U6: LM358; SOIC-8_3.9x4.9mm_P1.27mm; MPN LM358DR2G; LCSC C7950
U7: MMDT2227-7; SOT-363_DIO; MPN MMDT2227-7-F; LCSC C41375117
U8: MCP1416; SOT-23-5; MPN MCP1416T-E/OT; LCSC C83775

Connections:
+3V3: C49.1, R56.1, U5.8 (VCC); also elsewhere on the board
+12V: C50.1, C54.1, C55.1, C56.1, U6.8 (V+), U7.6 (C2), U8.2 (Vdd); also elsewhere on the board
/Strobe Generation/GATE-DRV: R61.2, R62.2, U8.3 (IN)
/Strobe Generation/PWR_LowSideD: Q9.3 (S), Q10.3 (D), R67.1
CurrentSense_ADC: Q10.2 (S), R65.2, R66.2, TP4.1 (1_1); also elsewhere on the board
GND: C49.2, C50.2, C52.1, C53.1, C54.2, C55.2, C56.2, Q8.2 (S), R54.1, R57.1, R59.2, R62.1, R65.1, R66.1, R67.2, U5.1 (~A), U5.4 (GND), U6.4 (V-), U6.5 (+), U7.3 (C1), U8.4 (GND); also elsewhere on the board
Gate_PWM: R55.1; also elsewhere on the board
unnamed: C52.2, R55.2, R58.1
unnamed: C51.2, Q8.3 (D), R56.2, U5.7 (RCext)
unnamed: Q9.1 (G), R63.2
unnamed: Q10.1 (G), R64.2
unnamed: C51.1, U5.6 (Cext)
unnamed: R61.1, U5.5 (Q)
unnamed: C53.2, R58.2, U6.3 (+)
unnamed: R59.1, R60.1, U6.2 (-)
unnamed: U6.6 (-), U6.7
unnamed: U6.1, U7.2 (B2), U7.5 (B1)
unnamed: R60.2, R63.1, TP3.1 (1_1), U7.1 (E2), U7.4 (E1)
unnamed: R64.1, U8.5 (OUT)
Pulse_Limit_Disable: Q8.1 (G), R54.2; also elsewhere on the board
Strobe_Pulse: R57.2, U5.2 (B), U5.3 (~CLR); also elsewhere on the board
VIR: D10.1 (K); also elsewhere on the board
VIR_RTN: D10.2 (A), Q9.2 (D); also elsewhere on the board

Notes on the sheet:
Hardware Watchdog Timer Limits max pulse duration to 113us Limit can be disabled with Pulse_Limit_Disable = True
Adjustable Constant Current Sink
Bleed resistor Max Drain-Source leakage current: 250uA Max voltage of floating source: 14V

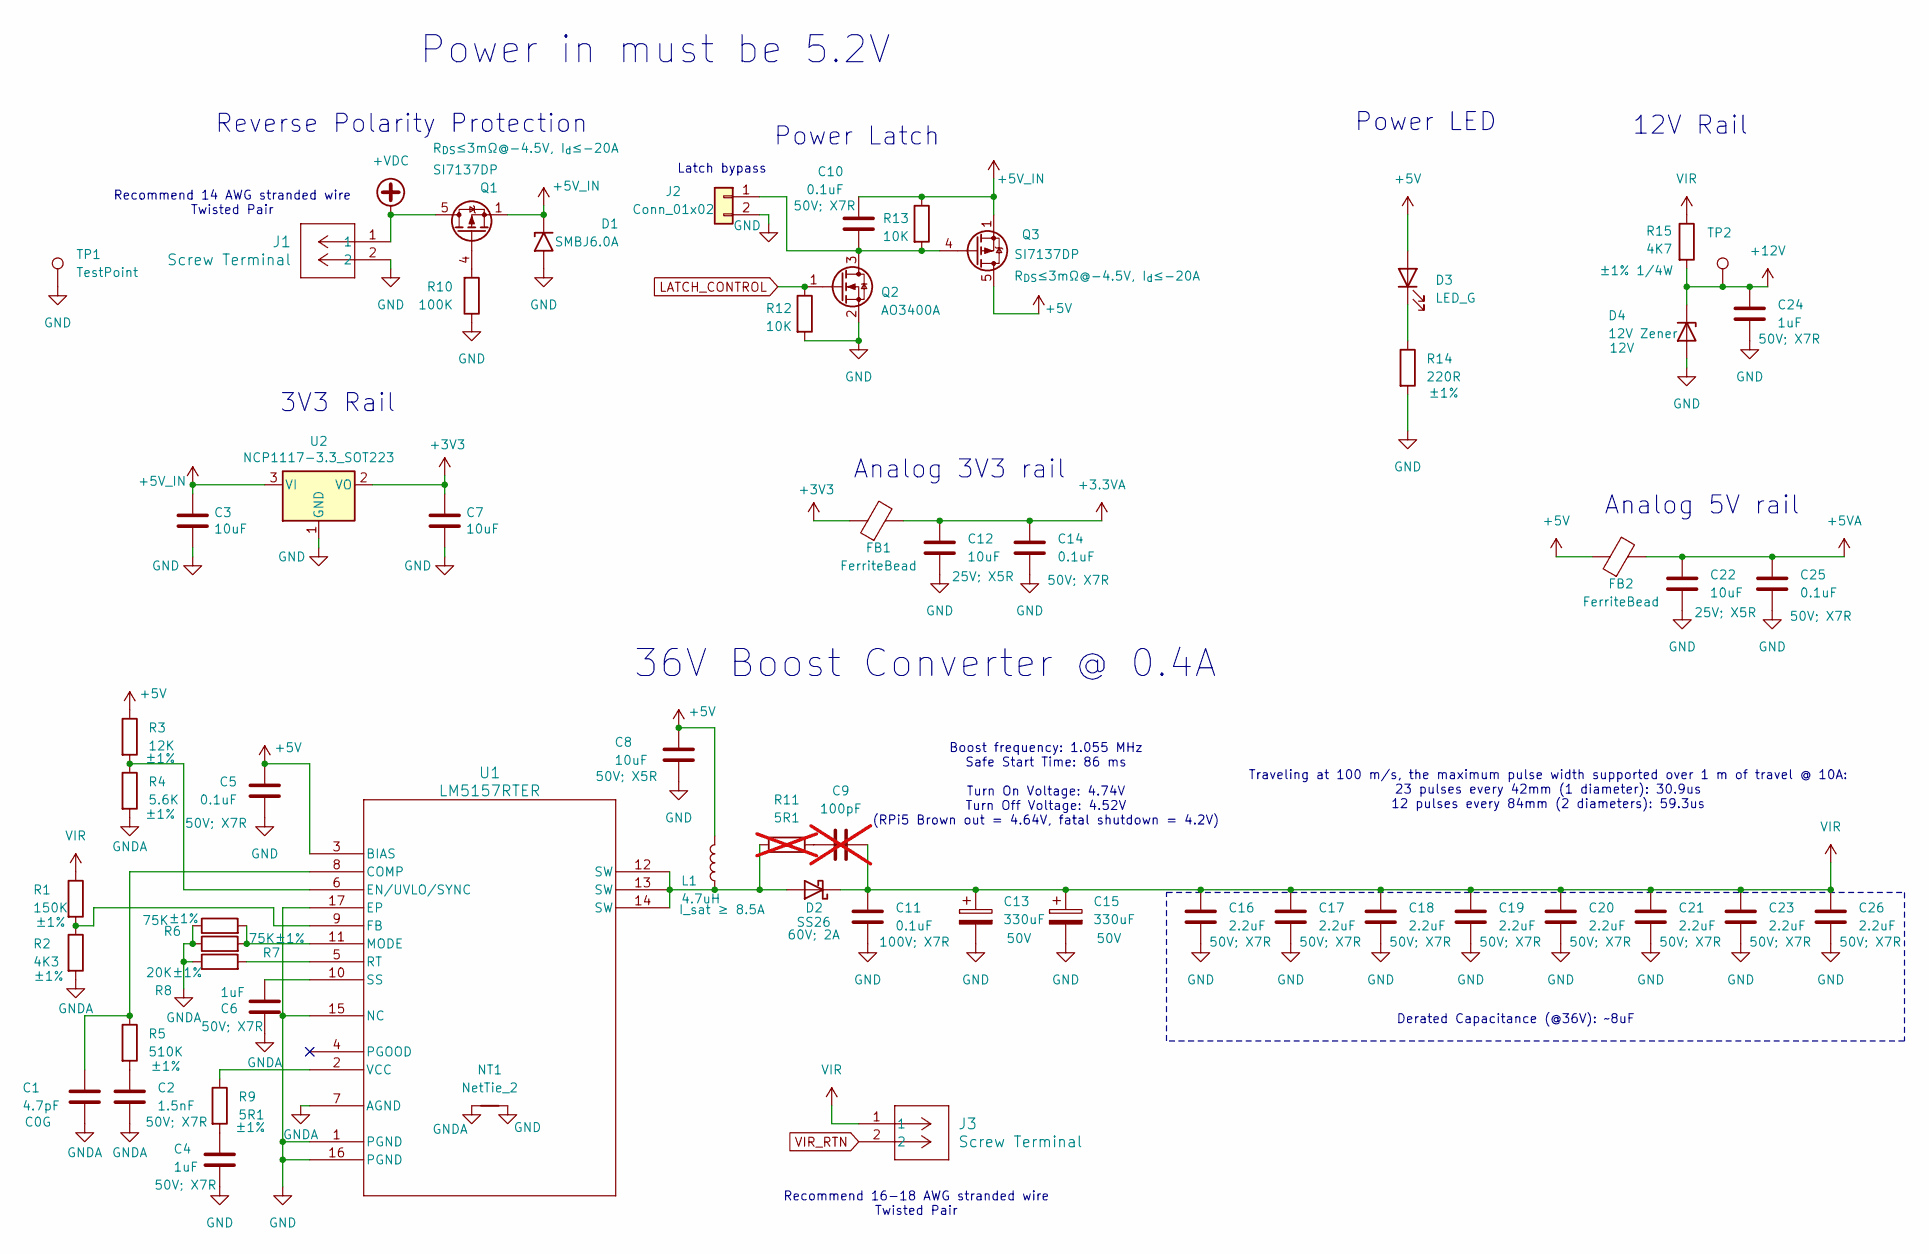
[picture p14: schematic Power.kicad_sch, V3 Connector + IRLED]

Parts:
C1: 4.7pF; C_0402_1005Metric; Ratings C0G; MPN GRM1555C1H4R7CA01D; LCSC C1569
C2: 1.5nF; C_0603_1608Metric; Ratings 50V; X7R; MPN GCD188R71H152KA01D; LCSC C1595
C3, C7, C12, C22: 10uF; C_0603_1608Metric; Ratings 25V; X5R; MPN CL10A106MA8NRNC; LCSC C96446
C4, C6, C24: 1uF; C_0805_2012Metric; Ratings 50V; X7R; MPN CL21B105KBFNNNE; LCSC C28323
C5, C10, C14, C25: 0.1uF; C_0402_1005Metric; Ratings 50V; X7R; MPN CL05B104KB54PNC; LCSC C307331
C8: 10uF; C_0805_2012Metric; Ratings 50V; X5R; MPN GRM21BR61H106KE43L; LCSC C440198
C9: 100pF; C_0603_1608Metric; Ratings 100V, C0G; MPN GCM1885C2A101JA16D; not fitted
C11: 0.1uF; C_0805_2012Metric; Ratings 100V; X7R; MPN CL21B104KCFNNNE; LCSC C28233
C13, C15: 330uF; CAP_50TPV_10x10.5_RBY; Ratings 50V; MPN 50TPV330M10X10.5; LCSC C53120968
C16, C17, C18, C19, C20, C21, C23, C26: 2.2uF; C_1206_3216Metric; Ratings 50V; X7R; MPN CL31B225KBHNNNE; LCSC C50254
D1: SMBJ6.0A; D_SMB; MPN SMBJ6.0A; LCSC C19077560
D2: SS26; D_SMA; Ratings 60V; 2A; MPN SS26S-E3/5AT; LCSC C7420363
D3: LED_G; LED_0805_2012Metric; MPN APT2012LZGCK; LCSC C2297
D4: 12V Zener; D_SOD-123; Ratings 12V; MPN BZT52B12; LCSC C22395569
FB1, FB2: FerriteBead; L_0603_1608Metric; MPN BLM18PG121SN1D; LCSC C14709
J1, J3: Screw Terminal; CONN2_710002_WRE; MPN 691137710002
J2: Conn_01x02; PinHeader_1x02_P2.54mm_Vertical; MPN PH1-02-UA
L1: 4.7uH; L_Abracon_ASPI-0630LR; Ratings I_sat ≥ 8.5A; MPN ASPI-0630HI-4R7M-T15; LCSC C207840
NT1: NetTie_2; NetTie-2_SMD_Pad0.5mm
Q1, Q3: SI7137DP; PQFN-8-EP_6x5mm_P1.27mm_Generic_ThermalVias; Ratings R_{DS}≤3mΩ@-4.5V, I_{d}≤-20A; MPN SI7137DP-T1-GE3; LCSC C42456927
Q2: AO3400A; SOT-23; MPN AO3400A; LCSC C20917
R1: 150K; R_0603_1608Metric; Ratings ±1%; MPN RMCF0603FT150K; LCSC C22807
R2: 4K3; R_0603_1608Metric; Ratings ±1%; MPN RMCF0603FT4K30; LCSC C23159
R3: 12K; R_0603_1608Metric; Ratings ±1%; MPN RMCF0603FT12K0; LCSC C22790
R4: 5.6K; R_0603_1608Metric; Ratings ±1%; MPN RMCF0603FT5K60; LCSC C23189
R5: 510K; R_0603_1608Metric; Ratings ±1%; MPN RMCF0603FT510K; LCSC C23192
R6, R7: 75K; R_0603_1608Metric; Ratings ±1%; MPN RMCF0603FT75K0; LCSC C23242
R8: 20K; R_0603_1608Metric; Ratings ±1%; MPN RMCF0603FT20K0; LCSC C4184
R9: 5R1; R_0805_2012Metric; Ratings ±1%; MPN RMCF0805FT5R10; LCSC C17724
R10: 100K; R_0402_1005Metric; Ratings ±1%; MPN RMCF0402FT100K; LCSC C25741
R11: 5R1; R_0805_2012Metric; Ratings ±1%, Pulse-Withstanding; MPN ERJ-P06J5R1V; not fitted
R12, R13: 10K; R_0402_1005Metric; Ratings ±1%; MPN RMCF0402FT10K0; LCSC C25744
R14: 220R; R_0402_1005Metric; Ratings ±1%; MPN RMCF0402FT220R; LCSC C25091
R15: 4K7; R_1206_3216Metric; Ratings ±1% 1/4W; MPN RMCF1206FT4K70; LCSC C17936
TP1: TestPoint; TestPoint_Keystone_5000-5004_Miniature; MPN 5001; Digikey PN 36-5001-ND
TP2: TestPoint; TestPoint_THTPad_D1.0mm_Drill0.5mm
U1: LM5157RTER; QFN_57RTER_TEX_ThermalVias; MPN LM5157RTER; LCSC C5219222
U2: NCP1117-3.3_SOT223; SOT-223-3_TabPin2; MPN NCP1117ST33T3G; LCSC C6186

Connections:
+3.3VA: C12.2, C14.2, FB1.2; also elsewhere on the board
+3V3: C7.1, FB1.1, U2.2 (VO); also elsewhere on the board
+5V: C5.2, C8.1, D3.2 (A), FB2.1, L1.2, Q3.5 (D), R3.1, U1.3 (BIAS); also elsewhere on the board
+5VA: C22.2, C25.2, FB2.2; also elsewhere on the board
+5V_IN: C3.1, C10.2, D1.1 (A1), Q1.1 (S), Q1.2 (S), Q1.3 (S), Q3.1 (S), Q3.2 (S), Q3.3 (S), R13.1, U2.3 (VI); also elsewhere on the board
+12V: C24.1, D4.1 (K), R15.2, TP2.1 (1_1); also elsewhere on the board
+VDC: J1.1, Q1.5 (D)
GND: C3.2, C4.2, C5.1, C7.2, C8.2, C11.2, C12.1, C13.2, C14.1, C15.2, C16.2, C17.2, C18.2, C19.2, C20.2, C21.2, C22.1, C23.2, C24.2, C25.1, C26.2, D1.2 (A2), D4.2 (A), J1.2, J2.2, NT1.2, Q2.2 (S), R10.1, R12.2, R14.2, TP1.1 (1_1), U1.1 (PGND), U1.15 (NC), U1.16 (PGND), U1.17 (EP), U2.1 (GND); also elsewhere on the board
GNDA: C1.2, C2.2, C6.2, NT1.1, R2.2, R4.2, R6.1, R7.1, R8.1, U1.7 (AGND)
LATCH_CONTROL: Q2.1 (G), R12.1; also elsewhere on the board
unnamed: C2.1, R5.2
unnamed: C4.1, R9.2
unnamed: C9.1, R11.2
unnamed: D2.2 (A), L1.1, R11.1, U1.12 (SW), U1.13 (SW), U1.14 (SW)
unnamed: D3.1 (K), R14.1
unnamed: C10.1, J2.1, Q2.3 (D), Q3.4 (G), R13.2
unnamed: Q1.4 (G), R10.2
unnamed: C1.1, R5.1, U1.8 (COMP)
unnamed: R3.2, R4.1, U1.6 (EN/UVLO/SYNC)
unnamed: R1.2, R2.1, U1.9 (FB)
unnamed: R6.2, R7.2, U1.11 (MODE)
unnamed: R8.2, U1.5 (RT)
unnamed: C6.1, U1.10 (SS)
unnamed: R9.1, U1.2 (VCC)
VIR: C9.2, C11.1, C13.1, C15.1, C16.1, C17.1, C18.1, C19.1, C20.1, C21.1, C23.1, C26.1, D2.1 (K), J3.1, R1.1, R15.1; also elsewhere on the board
VIR_RTN: J3.2; also elsewhere on the board

Notes on the sheet:
Traveling at 100 m/s, the maximum pulse width supported over 1 m of travel @ 10A: 23 pulses every 42mm (1 diameter): 30.9us 12 pulses every 84mm (2 diameters): 59.3us
Power Latch
Recommend 16-18 AWG stranded wire Twisted Pair
Power in must be 5.2V
Derated Capacitance (@36V): ~8uF
Analog 5V rail
Reverse Polarity Protection
Recommend 14 AWG stranded wire Twisted Pair
36V Boost Converter @ 0.4A
Analog 3V3 rail
12V Rail
Power LED
Latch bypass
Boost frequency: 1.055 MHz Safe Start Time: 86 ms Turn On Voltage: 4.74V Turn Off Voltage: 4.52V (RPi5 Brown out = 4.64V, fatal shutdown = 4.2V)
3V3 Rail
