peteattayek/PiTrac_V2/Hardware/The_Second_Board_To_Rule_Them_All/The_Second_Board_To_Rule_Them_All.kicad_pcb

## KiCad design Hardware/The_Second_Board_To_Rule_Them_All/The_Second_Board_To_Rule_Them_All.kicad_pcb (continued)

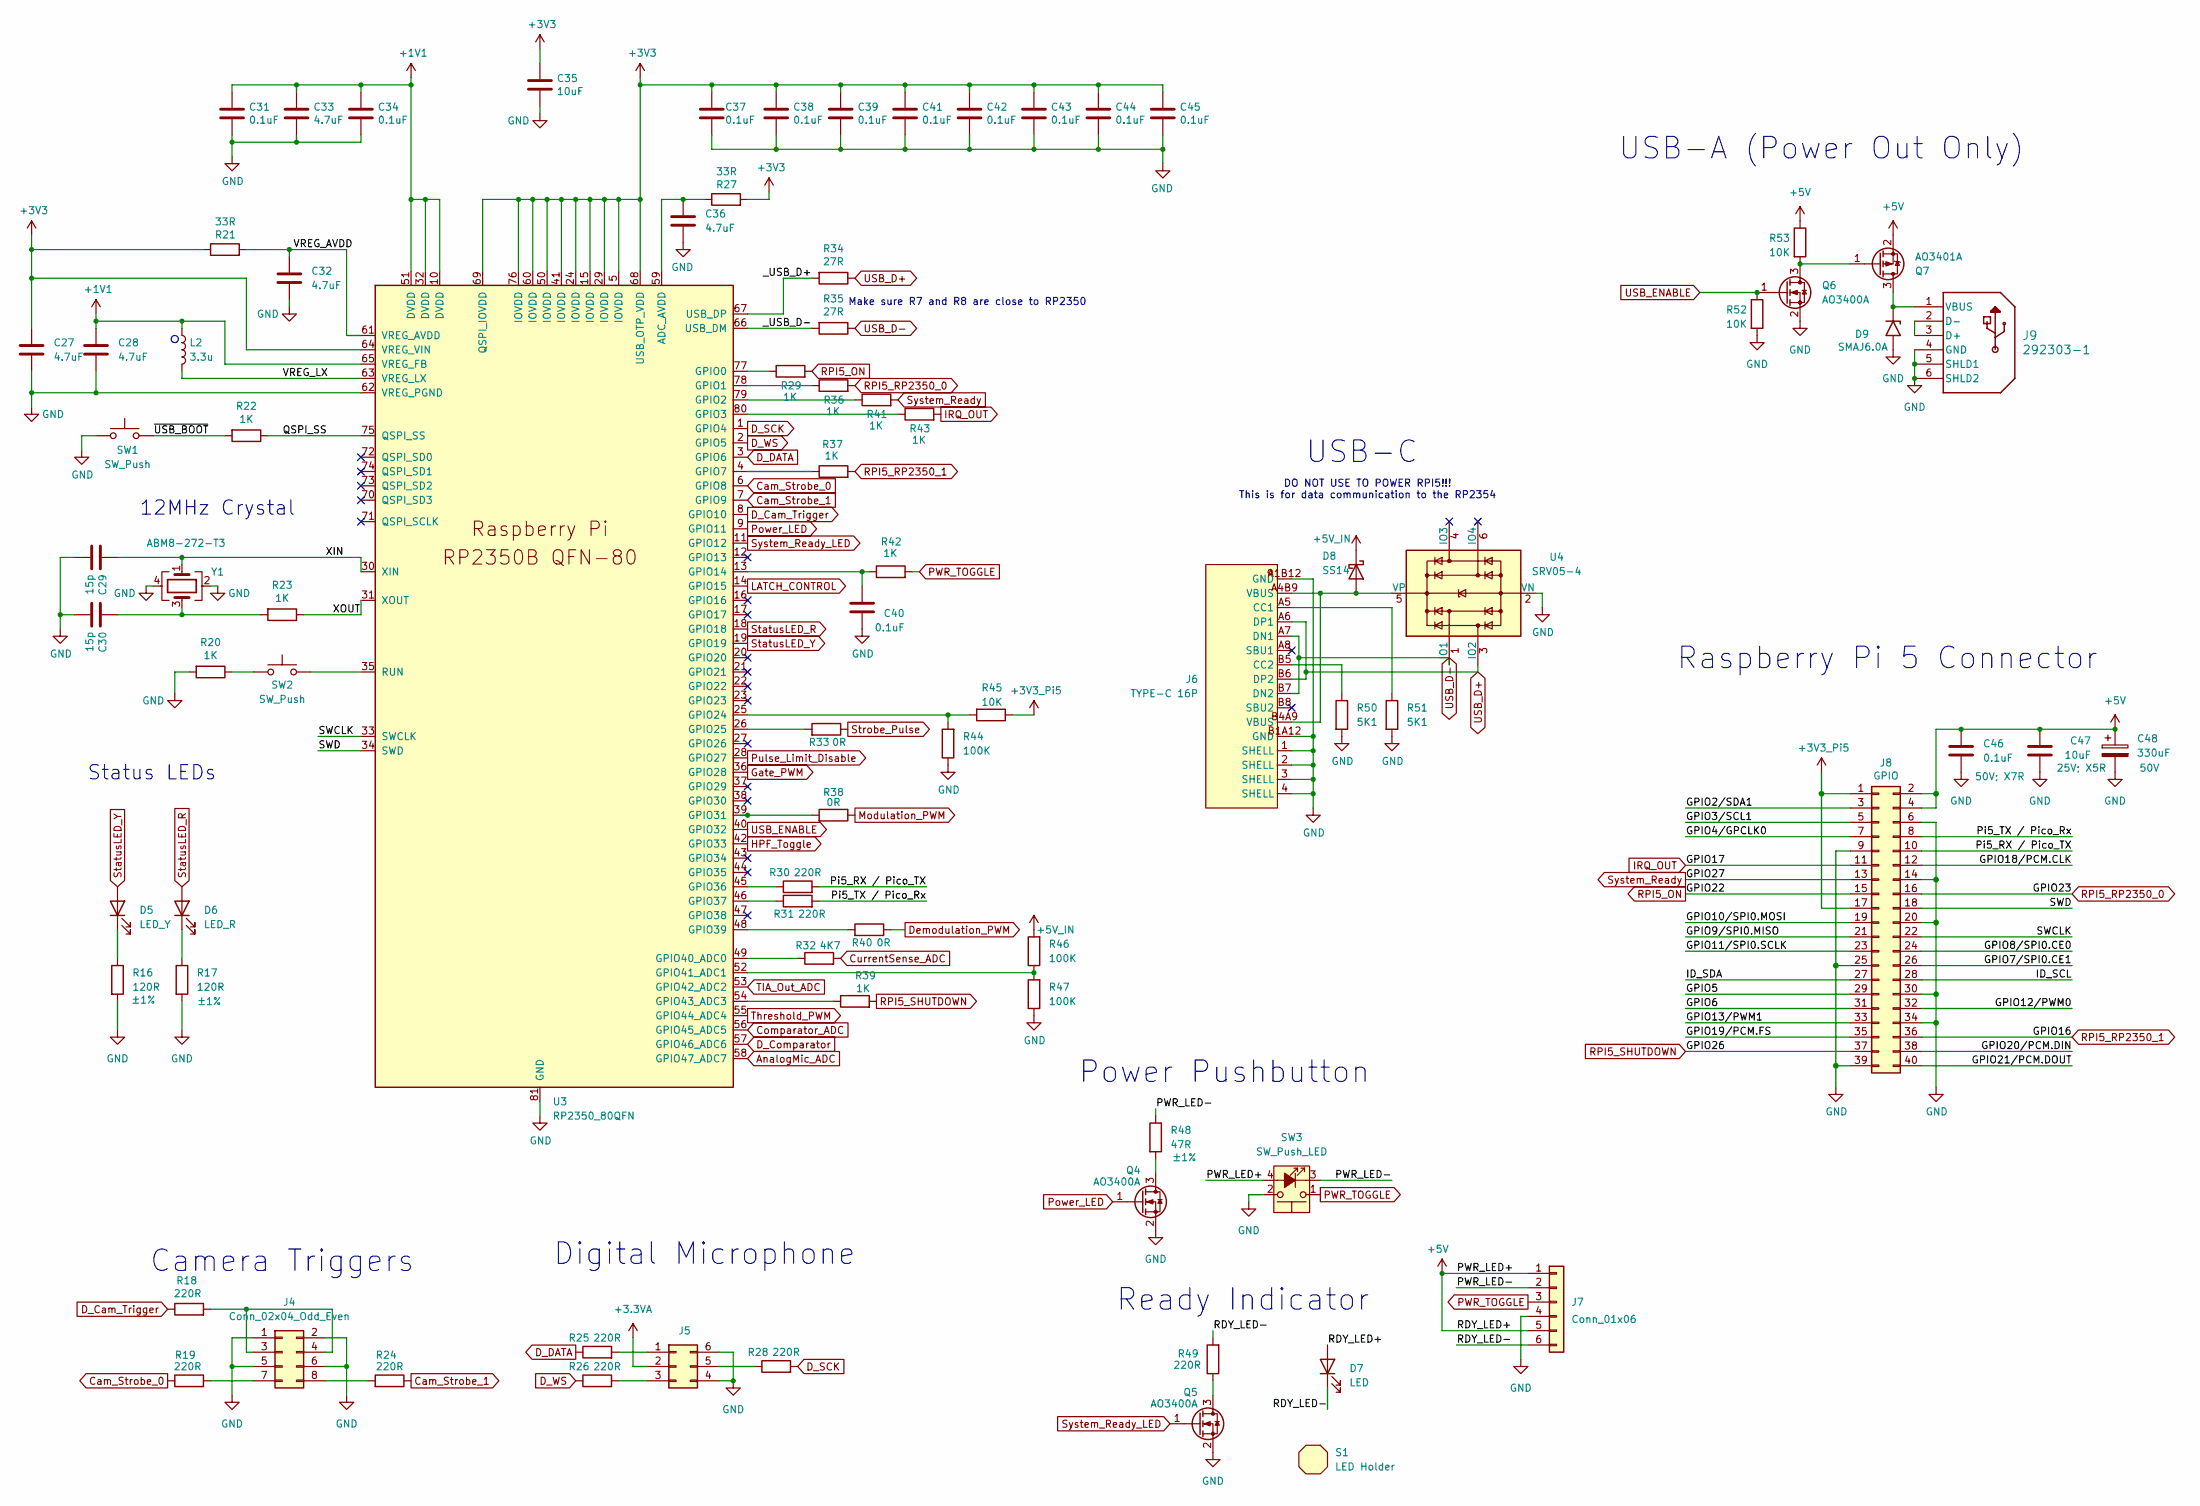
[picture p15: schematic RP2350_80QFN_minimal.kicad_sch, RP2350B QFN80 Minimal Design Example]

Parts:
C27, C28: 4.7uF; C_0402_1005Metric_small_pads; Ratings 10V; X5R; MPN CL05A475MP5NRNC; LCSC C23733
C29, C30: 15p; C_0402_1005Metric; Ratings C0G; MPN GRM1555C1H150JA01D; LCSC C1548
C31, C34, C37, C38, C39, C40, C41, C42, C43, C44, C45, C46: 0.1uF; C_0402_1005Metric; Ratings 50V; X7R; MPN CL05B104KB54PNC; LCSC C307331
C32, C33, C36: 4.7uF; C_0402_1005Metric; Ratings 10V; X5R; MPN CL05A475MP5NRNC; LCSC C23733
C35, C47: 10uF; C_0603_1608Metric; Ratings 25V; X5R; MPN CL10A106MA8NRNC; LCSC C96446
C48: 330uF; CAP_50TPV_10x10.5_RBY; Ratings 50V; MPN 50TPV330M10X10.5; LCSC C53120968
D5: LED_Y; LED_0603_1608Metric; MPN APT1608SYCK; LCSC C89811
D6: LED_R; LED_0603_1608Metric; MPN AA1608SURSK; LCSC C2286
D7: LED; MPN BL-BGE1V1
D8: SS14; D_SMA; MPN SS14; LCSC C2480
D9: SMAJ6.0A; D_SMA; MPN SMAJ6.0A; LCSC C19077525
J4: Conn_02x04_Odd_Even; PinHeader_2x04_P2.54mm_Vertical; MPN PH2-08-UA
J5: Conn_02x03_Counter_Clockwise; PinHeader_2x03_P2.54mm_Vertical; MPN PH2-06-UA
J6: TYPE-C 16P; USB-C-SMD_TYPE-C16PIN_C668624; MPN USB4105-GF-A; LCSC Part C668624
J7: Conn_01x06; PinHeader_1x06_P2.54mm_Vertical; MPN PH1-06-UA
J8: GPIO; PinSocket_2x20_P2.54mm_Vertical; MPN 16764
J9: 292303-1; CONN4_292303-1_TEC; MPN 292303-1
L2: 3.3u; L_pol_2016; MPN AOTA-B201610S3R3-101-T; LCSC C42411119
Q4, Q5: AO3400A; SOT-23; MPN AO3400A; LCSC C20917
Q6: AO3400A; SOT-23; MPN AO3400A; Digikey PN 785-1000-1-ND
Q7: AO3401A; SOT-23; MPN AO3401A; LCSC C15127
R16, R17: 120R; R_0402_1005Metric; Ratings ±1%; MPN RMCF0402FT120R; LCSC C25079
R18, R19, R24, R25, R26, R28, R30, R31, R49: 220R; R_0402_1005Metric; Ratings ±1%; MPN RMCF0402FT220R; LCSC C25091
R20, R22, R23, R29, R36, R37, R39, R41, R42, R43: 1K; R_0402_1005Metric; Ratings ±1%; MPN RMCF0402FT1K00; LCSC C11702
R21, R27: 33R; R_0402_1005Metric; Ratings ±1%; MPN RMCF0402FT33R0; LCSC C25105
R32: 4K7; R_1206_3216Metric; Ratings ±1% 1/4W; MPN RMCF1206FT4K70; LCSC C17936
R33, R38, R40: 0R; R_0805_2012Metric_Pad1.20x1.40mm_HandSolder; MPN RMCF0805ZT0R00; LCSC C17477
R34, R35: 27R; R_0603_1608Metric; Ratings ±1%; MPN RMCF0603FT27R0; LCSC C25190
R44, R46, R47: 100K; R_0402_1005Metric; Ratings ±1%; MPN RMCF0402FT100K; LCSC C25741
R45, R52, R53: 10K; R_0402_1005Metric; Ratings ±1%; MPN RMCF0402FT10K0; LCSC C25744
R48: 47R; R_0402_1005Metric; Ratings ±1%; MPN RMCF0402FT47R0; LCSC C25118
R50, R51: 5K1; R_0402_1005Metric; Ratings ±1%; MPN RMCF0402FT5K10; LCSC C25905
S1: LED Holder; MPN SSH-LXH501
SW1, SW2: SW_Push; SW_TS-1088_XNP; MPN TS-1088-AR02016; LCSC C720477
SW3: SW_Push_LED; MPN 481
U3: RP2350_80QFN; RP2350-QFN-80-1EP_10x10_P0.4mm_EP3.4x3.4mm_ThermalVias; MPN RP2354B; LCSC C39843328
U4: SRV05-4; SOT-23-6; MPN SRV05-4HTG-D; LCSC C7420376
Y1: ABM8-272-T3; Crystal_SMD_3225-4Pin_3.2x2.5mm; MPN ABM8-272-T3; LCSC C20625731

Connections:
+1V1: C28.1, C31.1, C33.1, C34.1, L2.1, U3.10 (DVDD), U3.32 (DVDD), U3.51 (DVDD), U3.65 (VREG_FB)
+3.3VA: J5.2; also elsewhere on the board
+3V3: C27.1, C35.1, C37.1, C38.1, C39.1, C41.1, C42.1, C43.1, C44.1, C45.1, R21.1, R27.2, U3.5 (IOVDD), U3.15 (IOVDD), U3.24 (IOVDD), U3.29 (IOVDD), U3.41 (IOVDD), U3.50 (IOVDD), U3.60 (IOVDD), U3.64 (VREG_VIN), U3.68 (USB_OTP_VDD), U3.69 (QSPI_IOVDD), U3.76 (IOVDD); also elsewhere on the board
+3V3_Pi5: J8.1, J8.17, R45.1
+5V: C46.2, C47.1, C48.1, D7.2 (A), J7.1, J7.5, J8.2, J8.4, Q7.2 (S), R53.1, SW3.4 (A); also elsewhere on the board
+5V_IN: D8.1 (K), R46.2; also elsewhere on the board
/MCU and Connectors/GPIO2/SDA1: J8.3
/MCU and Connectors/GPIO3/SCL1: J8.5
/MCU and Connectors/GPIO4/GPCLK0: J8.7
/MCU and Connectors/GPIO5: J8.29
/MCU and Connectors/GPIO6: J8.31
/MCU and Connectors/GPIO7/SPI0.CE1: J8.26
/MCU and Connectors/GPIO8/SPI0.CE0: J8.24
/MCU and Connectors/GPIO9/SPI0.MISO: J8.21
/MCU and Connectors/GPIO10/SPI0.MOSI: J8.19
/MCU and Connectors/GPIO11/SPI0.SCLK: J8.23
/MCU and Connectors/GPIO12/PWM0: J8.32
/MCU and Connectors/GPIO13/PWM1: J8.33
/MCU and Connectors/GPIO18/PCM.CLK: J8.12
/MCU and Connectors/GPIO19/PCM.FS: J8.35
/MCU and Connectors/GPIO20/PCM.DIN: J8.38
/MCU and Connectors/GPIO21/PCM.DOUT: J8.40
/MCU and Connectors/ID_SCL: J8.28
/MCU and Connectors/ID_SDA: J8.27
/MCU and Connectors/PWR_LED-: J7.2, R48.1, SW3.3 (K)
/MCU and Connectors/Pi5_RX / Pico_TX: J8.10, R30.2
/MCU and Connectors/Pi5_TX / Pico_Rx: J8.8, R31.2
/MCU and Connectors/QSPI_SS: R22.1, U3.75 (QSPI_SS)
/MCU and Connectors/RDY_LED-: D7.1 (K), J7.6, R49.2
/MCU and Connectors/SWCLK: J8.22, U3.33 (SWCLK)
/MCU and Connectors/SWD: J8.18, U3.34 (SWD)
/MCU and Connectors/VREG_AVDD: C32.1, R21.2, U3.61 (VREG_AVDD)
/MCU and Connectors/VREG_LX: L2.2, U3.63 (VREG_LX)
/MCU and Connectors/XIN: C29.1, U3.30 (XIN), Y1.1
/MCU and Connectors/XOUT: R23.1, U3.31 (XOUT)
/MCU and Connectors/_USB_D+: R34.2, U3.67 (USB_DP)
/MCU and Connectors/_USB_D-: R35.2, U3.66 (USB_DM)
/MCU and Connectors/~USB_BOOT: R22.2, SW1.2
AnalogMic_ADC: U3.58 (GPIO47_ADC7); also elsewhere on the board
Cam_Strobe_0: R19.1, U3.6 (GPIO8)
Cam_Strobe_1: R24.1, U3.7 (GPIO9)
Comparator_ADC: U3.56 (GPIO45_ADC5); also elsewhere on the board
CurrentSense_ADC: R32.2; also elsewhere on the board
D_Cam_Trigger: R18.1, U3.8 (GPIO10)
D_Comparator: U3.57 (GPIO46_ADC6); also elsewhere on the board
D_DATA: R25.1, U3.3 (GPIO6)
D_SCK: R28.2, U3.1 (GPIO4)
D_WS: R26.1, U3.2 (GPIO5)
Demodulation_PWM: R40.1; also elsewhere on the board
GND: C27.2, C28.2, C29.2, C30.2, C31.2, C32.2, C33.2, C34.2, C35.2, C36.2, C37.2, C38.2, C39.2, C40.1, C41.2, C42.2, C43.2, C44.2, C45.2, C46.1, C47.2, C48.2, D9.2 (A2), J4.1, J4.2, J4.5, J4.6, J5.4, J5.6, J6.1 (SHELL), J6.2 (SHELL), J6.3 (SHELL), J6.4 (SHELL), J6.A1B12 (GND), J6.B1A12 (GND), J7.4, J8.6, J8.9, J8.14, J8.20, J8.25, J8.30, J8.34, J8.39, J9.4 (GND), J9.5 (SHLD1), J9.6 (SHLD2), Q4.2 (S), Q5.2 (S), Q6.2 (S), R16.2, R17.2, R20.2, R44.1, R47.1, R50.2, R51.2, R52.2, SW1.1, SW3.2, U3.62 (VREG_PGND), U3.81 (GND), U4.2 (VN), Y1.2, Y1.4; also elsewhere on the board
Gate_PWM: U3.36 (GPIO28); also elsewhere on the board
HPF_Toggle: U3.42 (GPIO33); also elsewhere on the board
IRQ_OUT: J8.11, R43.2
LATCH_CONTROL: U3.14 (GPIO15); also elsewhere on the board
Modulation_PWM: R38.1; also elsewhere on the board
unnamed: C30.1, R23.2, Y1.3
unnamed: D5.1 (K), R16.1
unnamed: D6.1 (K), R17.1
unnamed: D8.2 (A), J6.A4B9 (VBUS), J6.B4A9 (VBUS), U4.5 (VP)
unnamed: D9.1 (A1), J9.1 (VBUS), Q7.3 (D)
unnamed: J4.3, J4.4, R18.2
unnamed: J4.7, R19.2
unnamed: J4.8, R24.2
unnamed: J5.1, R25.2
unnamed: J5.3, R26.2
unnamed: J5.5, R28.1
unnamed: J6.A5 (CC1), R51.1
unnamed: J6.B5 (CC2), R50.1
unnamed: J9.2 (D-), J9.3 (D+)
unnamed: Q4.3 (D), R48.2
unnamed: Q5.3 (D), R49.1
unnamed: Q6.3 (D), Q7.1 (G), R53.2
unnamed: R20.1, SW2.1
unnamed: C36.1, R27.1, U3.59 (ADC_AVDD)
unnamed: R29.1, U3.77 (GPIO0)
unnamed: R36.1, U3.78 (GPIO1)
unnamed: R41.1, U3.79 (GPIO2)
unnamed: R43.1, U3.80 (GPIO3)
unnamed: R37.1, U3.4 (GPIO7)
unnamed: C40.2, R42.1, U3.13 (GPIO14)
unnamed: R44.2, R45.2, U3.25 (GPIO24)
unnamed: R33.2, U3.26 (GPIO25)
unnamed: R38.2, U3.39 (GPIO31)
unnamed: R30.1, U3.45 (GPIO36)
unnamed: R31.1, U3.46 (GPIO37)
unnamed: R40.2, U3.48 (GPIO39)
unnamed: R32.1, U3.49 (GPIO40_ADC0)
unnamed: R46.1, R47.2, U3.52 (GPIO41_ADC1)
unnamed: R39.1, U3.54 (GPIO43_ADC3)
unnamed: SW2.2, U3.35 (RUN)
PWR_TOGGLE: J7.3, R42.2, SW3.1
Power_LED: Q4.1 (G), U3.9 (GPIO11)
Pulse_Limit_Disable: U3.28 (GPIO27); also elsewhere on the board
RPI5_ON: J8.15, R29.2
RPI5_RP2350_0: J8.16, R36.2
RPI5_RP2350_1: J8.36, R37.2
RPI5_SHUTDOWN: J8.37, R39.2
StatusLED_R: D6.2 (A), U3.18 (GPIO18)
StatusLED_Y: D5.2 (A), U3.19 (GPIO19)
Strobe_Pulse: R33.1; also elsewhere on the board
System_Ready: J8.13, R41.2
System_Ready_LED: Q5.1 (G), U3.11 (GPIO12)
TIA_Out_ADC: U3.53 (GPIO42_ADC2); also elsewhere on the board
Threshold_PWM: U3.55 (GPIO44_ADC4); also elsewhere on the board
USB_D+: J6.A6 (DP1), J6.B6 (DP2), R34.1, U4.3 (IO2)
USB_D-: J6.A7 (DN1), J6.B7 (DN2), R35.1, U4.1 (IO1)
USB_ENABLE: Q6.1 (G), R52.1, U3.40 (GPIO32)

Notes on the sheet:
12MHz Crystal
USB-C
DO NOT USE TO POWER RPI5!!! This is for data communication to the RP2354
Ready Indicator
Status LEDs
Camera Triggers
Digital Microphone
USB-A (Power Out Only)
Power Pushbutton
Raspberry Pi 5 Connector
Make sure R7 and R8 are close to RP2350

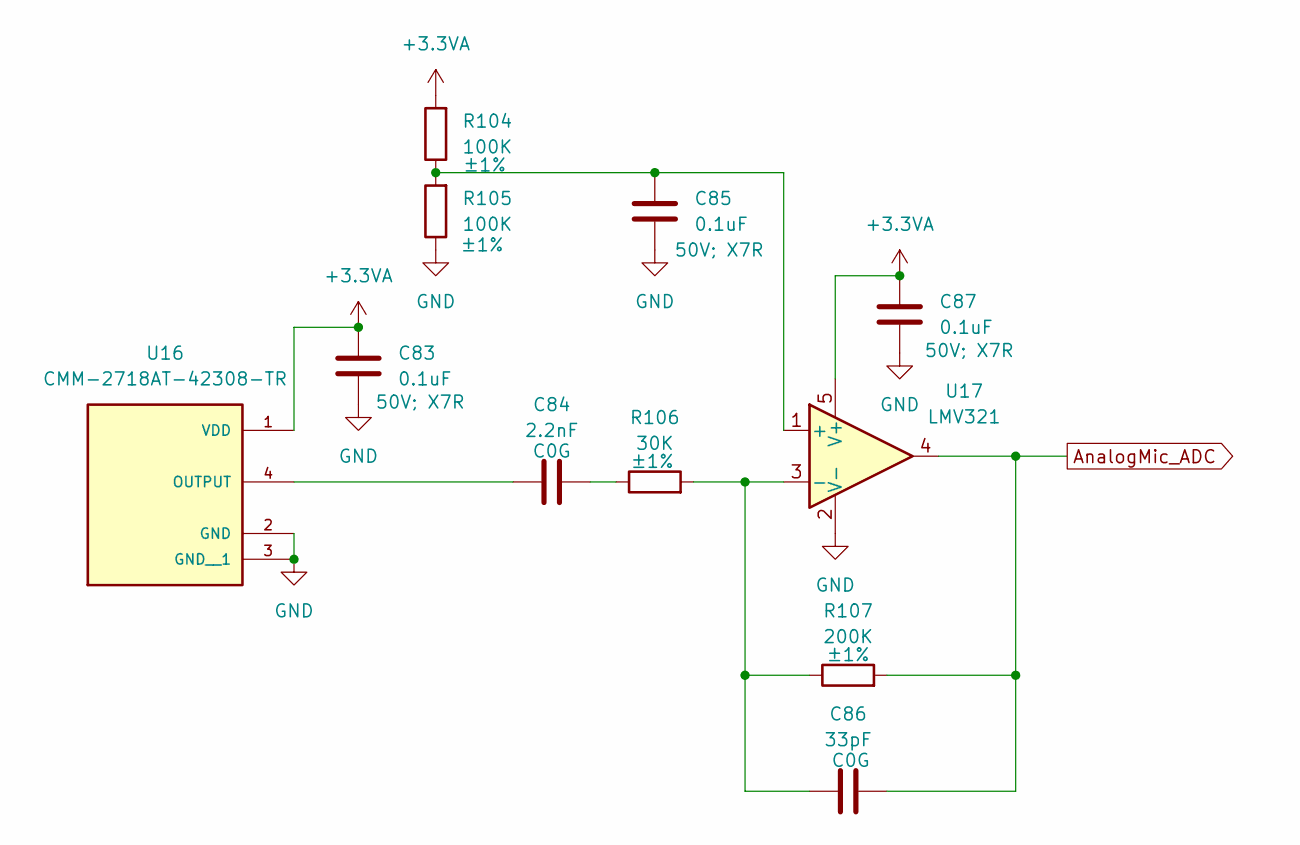
[picture p16: schematic microphone.kicad_sch]

Parts:
C83, C85, C87: 0.1uF; C_0402_1005Metric; Ratings 50V; X7R; MPN CL05B104KB54PNC; LCSC C307331
C84: 2.2nF; C_0805_2012Metric; Ratings C0G; MPN CL21C222JBFNNNE; LCSC C28260
C86: 33pF; C_0603_1608Metric; Ratings C0G; MPN CL10C330JB8NNNC; LCSC C1663
R104, R105: 100K; R_0402_1005Metric; Ratings ±1%; MPN RMCF0402FT100K; LCSC C25741
R106: 30K; R_0603_1608Metric; Ratings ±1%; MPN RMCF0603FT30K0; LCSC C22984
R107: 200K; R_0402_1005Metric; Ratings ±1%; MPN RMCF0402FT200K; LCSC C25764
U16: CMM-2718AT-42308-TR; XDCR_CMM-2718AT-42308-TR; MPN CMM-2718AT-42308-TR; LCSC C481300
U17: LMV321; SOT-23-5; MPN LMV321IDBVR; LCSC C7972

Connections:
+3.3VA: C83.2, C87.2, R104.2, U16.1 (VDD), U17.5 (V+); also elsewhere on the board
AnalogMic_ADC: C86.2, R107.2, U17.4; also elsewhere on the board
GND: C83.1, C85.1, C87.1, R105.1, U16.2 (GND), U16.3 (GND__1), U17.2 (V-); also elsewhere on the board
unnamed: C84.2, R106.1
unnamed: C84.1, U16.4 (OUTPUT)
unnamed: C85.2, R104.1, R105.2, U17.1 (+)
unnamed: C86.1, R106.2, R107.1, U17.3 (-)

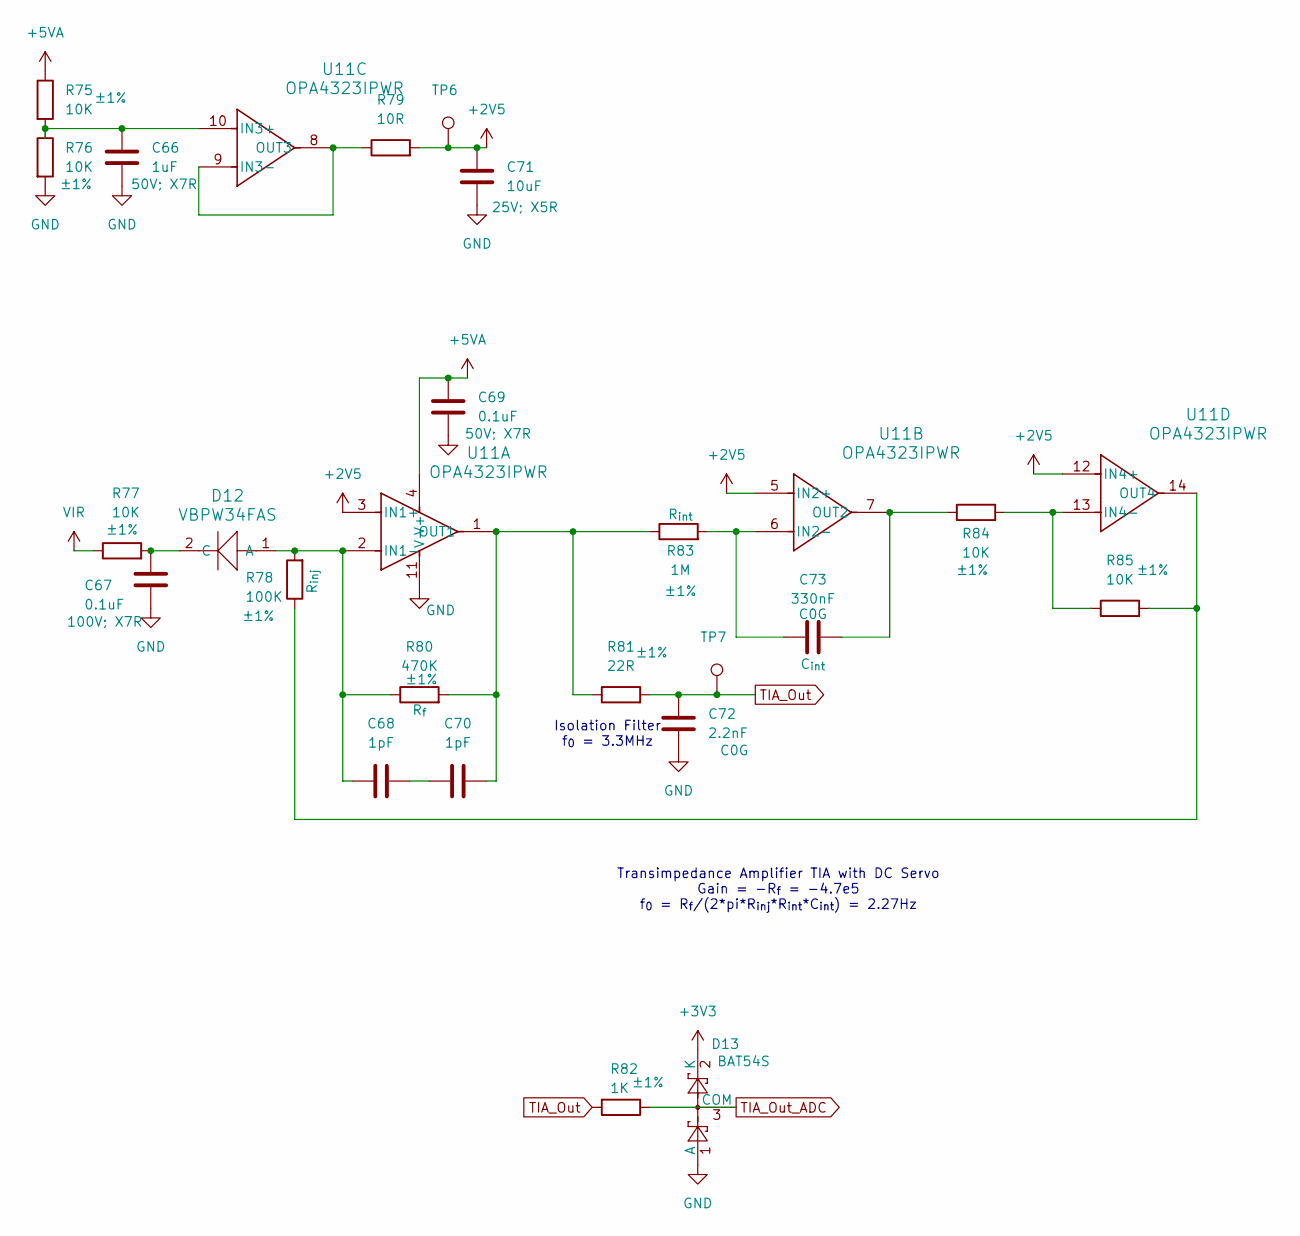
[picture p17: schematic photodiode.kicad_sch]

Parts:
C66: 1uF; C_0805_2012Metric; Ratings 50V; X7R; MPN CL21B105KBFNNNE; LCSC C28323
C67: 0.1uF; C_0805_2012Metric; Ratings 100V; X7R; MPN CL21B104KCFNNNE; LCSC C28233
C68, C70: 1pF; C_0402_1005Metric; Ratings C0G; MPN GRM1555C1H1R0BA01D; LCSC C1550
C69: 0.1uF; C_0402_1005Metric; Ratings 50V; X7R; MPN CL05B104KB54PNC; LCSC C307331
C71: 10uF; C_0603_1608Metric; Ratings 25V; X5R; MPN CL10A106MA8NRNC; LCSC C96446
C72: 2.2nF; C_0805_2012Metric; Ratings C0G; MPN CL21C222JBFNNNE; LCSC C28260
C73: 330nF; C_1206_3216Metric; Ratings C0G; MPN GRM31C5C1E334JE01L; LCSC C3837965
D12: VBPW34FAS; CR_W34FAS_VIS; MPN VBPW34FAS; LCSC C413453
D13: BAT54S; SOT-23; MPN BAT54SLT1G; LCSC C7420333
R75, R76, R77, R84, R85: 10K; R_0402_1005Metric; Ratings ±1%; MPN RMCF0402FT10K0; LCSC C25744
R78: 100K; R_0402_1005Metric; Ratings ±1%; MPN RMCF0402FT100K; LCSC C25741
R79: 10R; R_0402_1005Metric; Ratings ±1%; MPN RMCF0402FT10R0; LCSC C25077
R80: 470K; R_0603_1608Metric; Ratings ±1%; MPN RMCF0603FT470K; LCSC C23178
R81: 22R; R_0402_1005Metric; Ratings ±1%; MPN RMCF0402FT22R0; LCSC C25092
R82: 1K; R_0402_1005Metric; Ratings ±1%; MPN RMCF0402FT1K00; LCSC C11702
R83: 1M; R_0603_1608Metric; Ratings ±1%; MPN RMCF0603FT1M00; LCSC C22935
TP6, TP7: TestPoint; TestPoint_THTPad_D1.0mm_Drill0.5mm
U11: OPA4323IPWR; PW0014A-IPC_A; MPN OPA4323IPWR; LCSC C22419728

Connections:
+2V5: C71.1, R79.2, TP6.1 (1_1), U11.3 (IN1+), U11.5 (IN2+), U11.12 (IN4+); also elsewhere on the board
+3V3: D13.2 (K); also elsewhere on the board
+5VA: C69.1, R75.1, U11.4 (V+); also elsewhere on the board
GND: C66.2, C67.2, C69.2, C71.2, C72.2, D13.1 (A), R76.2, U11.11 (V-); also elsewhere on the board
unnamed: C68.1, C70.2
unnamed: C68.2, D12.1 (A), R78.2, R80.1, U11.2 (IN1-)
unnamed: C67.1, D12.2 (C), R77.2
unnamed: C70.1, R80.2, R81.1, R83.1, U11.1 (OUT1)
unnamed: C73.1, R83.2, U11.6 (IN2-)
unnamed: C73.2, R84.1, U11.7 (OUT2)
unnamed: C66.1, R75.2, R76.1, U11.10 (IN3+)
unnamed: R79.1, U11.8 (OUT3), U11.9 (IN3-)
unnamed: R84.2, R85.1, U11.13 (IN4-)
unnamed: R78.1, R85.2, U11.14 (OUT4)
TIA_Out: C72.1, R81.2, R82.2, TP7.1 (1_1); also elsewhere on the board
TIA_Out_ADC: D13.3 (COM), R82.1; also elsewhere on the board
VIR: R77.1; also elsewhere on the board

Notes on the sheet:
Isolation Filter f_{0} = 3.3MHz
Transimpedance Amplifier TIA with DC Servo Gain = -R_{f} = -4.7e5 f_{0} = R_{f}/(2*pi*R_{inj}*R_{int}*C_{int}) = 2.27Hz

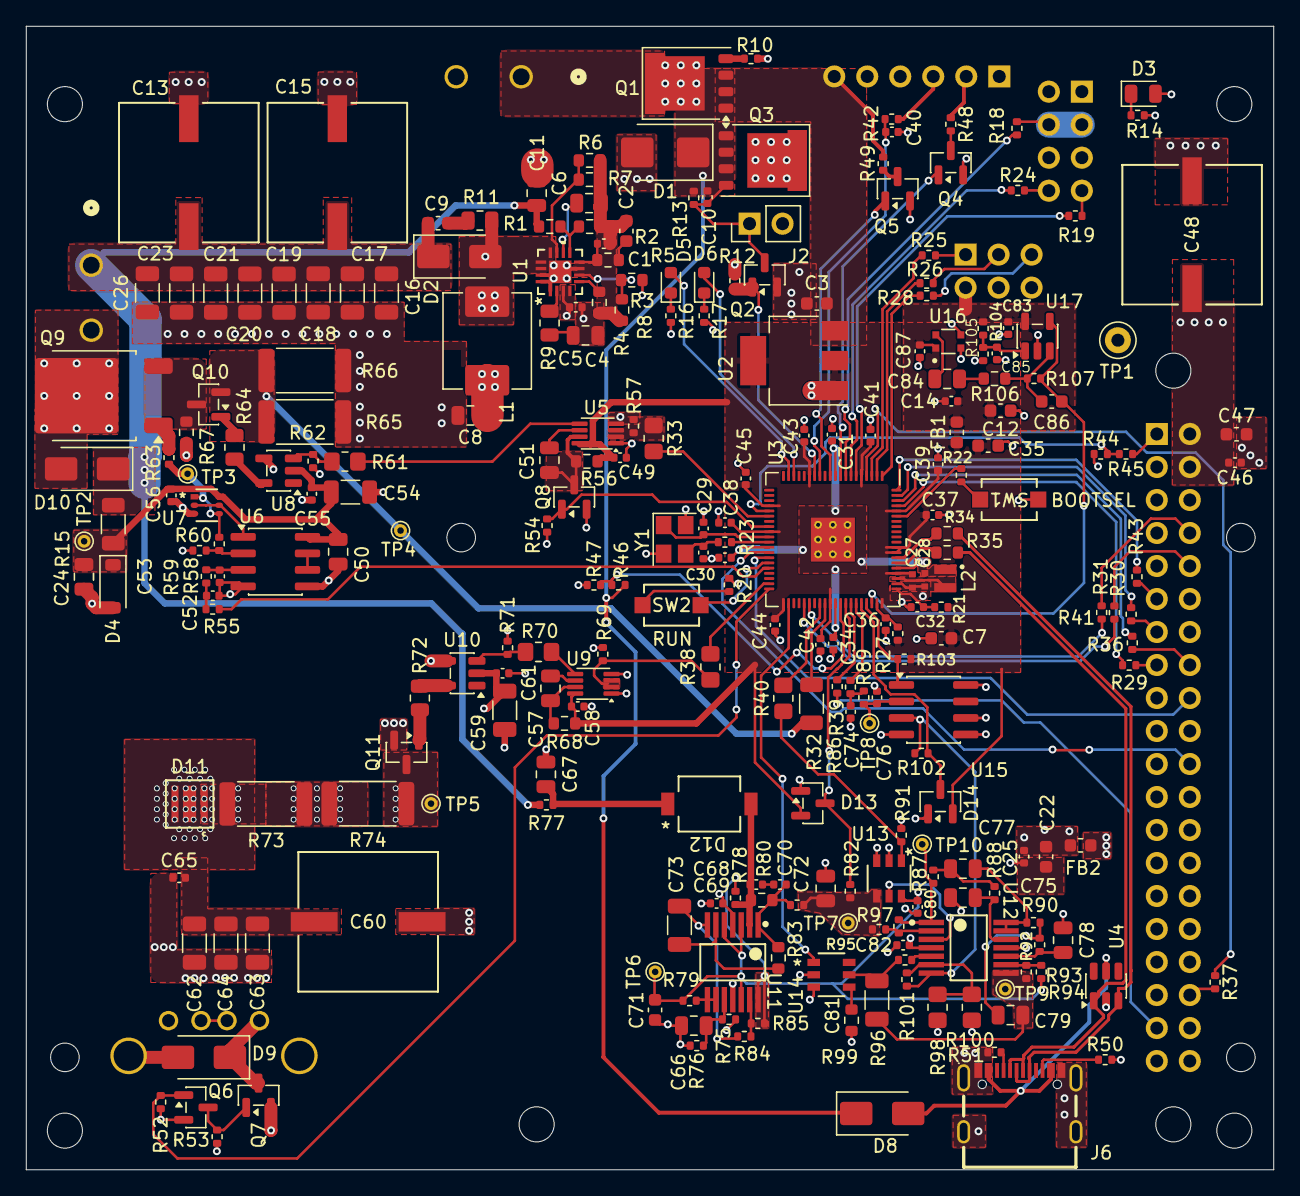
[picture p18: board The_Second_Board_To_Rule_Them_All.kicad_pcb from above]

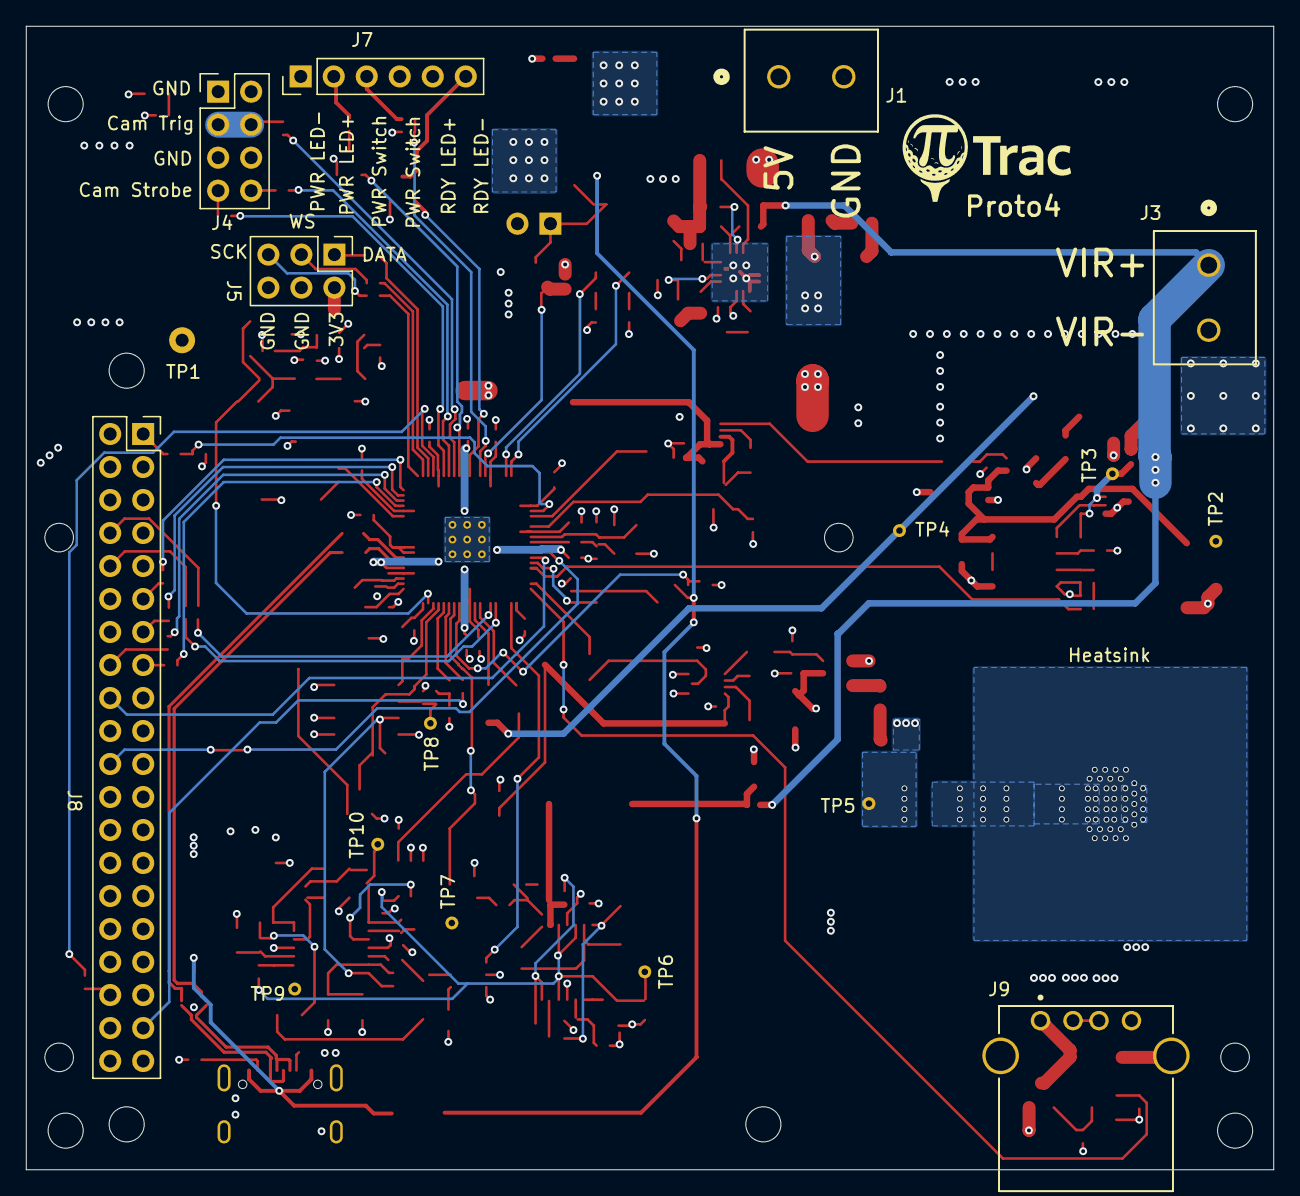
[picture p19: board The_Second_Board_To_Rule_Them_All.kicad_pcb from below]

Board: 4 copper layers, 96.0 x 88.0 mm, 273 parts (11 on the bottom side), 165 nets.

Other parts of the board:
MH1, MH2, MH4: MountingHole_2.7mm_M2.5
