peteattayek/PiTrac_V2/(commit log)

2026-07-31 Initial commit - phase 1 complete
    [BOM-The_Second_Board_To_Rule_Them_All.csv, IRLED.kicad_sch, MCU.kicad_sch, Power.kicad_sch, RP2350_80QFN_minimal.kicad_sch, Strobe Generation.kicad_sch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]
2026-08-14 Phase 3 steps 1-2: detection module, plus two hardware findings
    Carries the A1 DMA-ring work and doc updates that were already in the tree,
    then adds the first two steps of Phase 3 firmware.
    Step 1 - safety and hygiene:
    * Beam duty ceiling moved out of the cli.c `beam duty` branch and into
    beam_configure()/beam_set_duty(), so `beam freq`, `beam clamp` and
    `beam sweep` are covered too. Enforced on EFFECTIVE duty - what reaches
    the LED after U9's 122.68 us one-shot truncates the high phase - not on
    commanded duty. That distinction is load-bearing: `beam clamp` at
    1 kHz/50 % is an effective 12.3 % and must stay legal, while 104 kHz/50 %
    is an effective 50 % and must not. The old t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
2026-08-14 Phase 3 step 3: PIO comparator transit timer
    src/detect.pio, src/pio_alloc.[ch], and the C consumer in detect.c.
    ARCHITECTURE.md A2 - comparator edge timing as a state machine rather than a
    GPIO ISR, so the interval is measured by a counter that never does anything
    else and arrives as one FIFO word that is already the answer.
    PIO block allocation is forced, not chosen. Each RP2350 PIO block has one
    GPIOBASE holding only 0 or 16, giving a 32-pin window. GPIO46 (comparator) is
    reachable only at base 16; GPIO4/5/6 (mic), 8/9/10 (cameras) only at base 0.
    So the detector cannot share a block with either - an allocation that violates
    this does not perform badly, it fails to configure, and the SDK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
    [cli.c, detect.h, main.c, pio_alloc.c, pio_alloc.h]
2026-08-14 PROGRESS: resume state through step 3, and the step 4/5 entry points
    Records the PIO GPIOBASE partition, the chatter-coalescing rationale, and two
    things the next session must not rediscover the hard way: ADC5 saturates at
    full scale before D14 conducts (and biases transit the OPPOSITE way to the
    comparator), and cal demod must chop with beam_set_duty(0) rather than
    beam_enable(false), which would stop the demod clock and make the off
    half-cycle a different circuit instead of a dark reference.
2026-08-14 Phase 3 step 4: ADC refinement, per-pass log, Phase 4 stats table
    adc_ring_view() gives O(1) zero-copy access to the ring. adc_ring_history()
    copies, and 8192 samples of strided modular indexing costs several hundred
    microseconds - which does not fit inside the 100-300 us camera-handshake
    window the refinement is supposed to hide in. The view goes stale by design;
    adc_ring_view_valid() is called AFTER the analysis with the oldest index
    actually touched, and the result is discarded if the DMA lapped.
    detect_refine() measures the bump by its own shape rather than against a fixed
    threshold: baseline from well before the rise (not a global minimum - ADC5
    wanders in TRACK and drifts in HOLD, so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
    [adc_engine.c, adc_engine.h, cli.c, detect.h]
2026-08-14 Phase 3 step 5: beam chopping, demod phase model, scan carrier, R98 selection
    Chop with beam_set_duty(0), never beam_enable(false). Disabling the slices
    stops the DEMODULATOR CLOCK as well as the carrier, so U13's mux sits at one
    fixed sign and the dark half-cycle is a different circuit with a different DC
    operating point - not a reference. Setting the carrier compare level to 0
    means the pin never rises, U9 never fires and the LED is dark, while the demod
    slice keeps running with phase lock intact. Only the light changes, which is
    what a differential measurement assumes. This would have quietly corrupted
    every measurement in 3.4 and 3.6.
    Chop at 20 Hz, not the doc's 5 Hz. With tau = 0.66 s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
    [beam.c, beam.h, cal.c, cal.h, cli.c]
2026-08-14 Phase 3 step 6: versioned CRC'd flash config, dual slot, guarded save
    Persists what Phase 3 is expensive to reacquire: demod phase (a 26 s sweep),
    the phase model (five of them), the chosen carrier (minutes of warm beam), the
    threshold, and the ADC 5V scale that PROGRESS.md section 9 records as RAM-only.
    Sixteen words are reserved for the Phase 8 halt telemetry counters, which were
    always going to ride on this machinery.
    Dual alternating slots in the last 8 KB. The wear levelling is incidental; the
    reason is power-fail atomicity - the sector holding the only good copy is never
    the one being erased, so a reset mid-save costs the newest write and never the
    config. Newest valid seq wins, and a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
    [cli.c, config_store.c, config_store.h, main.c]
2026-08-14 Phase 3 step 7: correct the docs against the netlist and record the findings
    BENCH_P3_DETECT.md gets a corrections table up front, because two of the items
    change what you do at the bench rather than merely what you believe:
    - R98 is the DNP part, not R100. They are a parallel pair from GND to U12B's
    inverting input and R100 (2 k) is fitted. R98 was left unpopulated so its
    VALUE could be chosen after measuring, so gain is a continuous knob - the
    doc now carries the formula, a table of E24 options with their clip points,
    and points at "cal gain".
    - gpio 33 1 = TRACK was never verified. The netlist encodes only the pin name
    SEL. Run "hpf test" first; everything downstr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
2026-08-15 Fix 14 defects from two review passes; record the cross-phase ring constraint
    Three of these would have produced confidently wrong bench results rather than
    failures, which is the worse outcome because nothing looks broken.
    CRITICAL
    refine() anchored its search window at k=0, "the newest sample right now". But
    close_pass() fires from the coalesce timeout, so it always ran at least
    DETECT_COALESCE_US after the fall, plus superloop latency. With a guard of half
    a transit, any transit shorter than about twice the coalesce window put the bump
    entirely outside the search range - at 40 m/s the transit is ~1 ms and the bump
    sat ~2 ms further back than the window reached. It did not error; it meas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
    [adc_engine.c, adc_engine.h, cal.c, cli.c, config_store.c, config_store.h, detect.h]
2026-08-15 Pre-bench netlist verification across all 10 KiCad sheets
    Checked every schematic sheet before Phase 3 bench work, not just the photodiode
    and demodulation ones reviewed earlier. Nothing found blocks the bench, but four
    of these are numbers you would otherwise derive at the bench from a wrong premise.
    VERIFIED CLEAN
    All 30 board.h pin definitions and all 5 ADC channels cross-checked against the
    netlist mechanically rather than by eye. Every one maps to a real named net; none
    maps to an unconnected or missing node.
    DNP inventory is complete across all sheets: exactly three electrical parts are
    unpopulated - R98 (the detect gain option), C9 (100 pF on VIR) and R11 (5R1,
    Power). Everything e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
2026-08-15 Generate HARDWARE_REFERENCE.md from the KiCad source instead of by hand
    Parsing the netlist cost real effort and was done three separate times during
    Phase 3, so a summary is worth having. But a hand-written one is exactly the
    thing that keeps going wrong on this project: the bench doc named R100 as the
    unpopulated gain part when it is R98, board.h carried four PWM_SLICE_* constants
    of which three were wrong, board.h's "16 apart" collision rule is wrong above
    GPIO32, and ARCHITECTURE.md assigned comparator timing to a PIO block that
    physically cannot reach GPIO46. Every one was a human summary that had drifted
    from the hardware, and each was believed until something forced a re-derivation.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
    [board.h, netlist_report.py]
2026-08-15 Q6 ANSWERED: Mira220 digital I/O is 1.8 V with no 3.3 V tolerance
    From the ams-OSRAM datasheet, DS000642 v9-00 (2025-Sep-26), tables 2 and 3.
    VDD18 I/O supply 1.70 / 1.80 / 1.90 V (absolute max 4.125 V)
    IVDD18 supply draw 0.6 mA max
    VIH 0.7*VDD18 .. VDD18 <- max IS VDD18. No 3.3 V tolerance.
    VOH 0.8*VDD18 .. VDD18 <- min 1.44 V, ceiling 1.80 V
    ISCR latch-up +/- 100 mA
    Both directions fail, and the 220 Ohm series resistors fix neither - they limit
    current, they shift no levels.
    READ. Cam_Strobe_0/1 are RP2350 inputs. The sensor cannot output above 1.80 V
    against an RP2350 VIH of ~2.15 V, so those inputs can never read high and t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
2026-08-17 HPF polarity RESOLVED on hardware: GPIO33=0 is TRACK, not 1
    First bench run of the Phase 3 firmware. Steps 1-4 all pass:
    - boots and enumerates; pio_alloc_init() does not trip its asserts
    - detect reports PIO block 2, GPIOBASE 16, SM 0 - the A2 allocation is
    confirmed on silicon, not just against the SDK headers
    - D_Comparator reads high with the rail down, as predicted: U15 is unpowered
    so its open collector is high-Z and R103 pulls GPIO46 to +3V3
    - threshold DAC correct on a DMM at 0 / 25 / 50 / 75 %, settling inside 20 ms
    - adc 2 = 2.5884 V against the expected 2.59; 5V_IN 5.207 V; ring RUNNING
    hpf test reported INVERTED, and the TMUX1219 datasheet independently agrees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
    [board.h, detect.h]
2026-08-17 Fix hpf test: it was measuring its own settling, not the pin level
    The test reported INVERTED twice on hardware - once for each value of the
    constant it exists to validate. Both verdicts were meaningless.
    Two runs, laid side by side, show it:
    run 1 1st sampled: GPIO33=1 drift 33.0 mV mean 18.3 mV
    2nd sampled: GPIO33=0 drift 5.6 mV mean 6.2 mV
    run 2 1st sampled: GPIO33=0 drift 33.8 mV mean 21.0 mV
    2nd sampled: GPIO33=1 drift 4.8 mV mean 7.0 mV
    The drift tracks the ORDER OF MEASUREMENT, not GPIO33. Whichever state was
    sampled first showed ~33 mV; whichever was sampled second showed ~5 mV.
    Cause: sample_drift_v() pre-settled for 200 ms against an HPF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
    [cli.c, detect.h]
2026-08-17 HPF polarity CLOSED on hardware; measure and document ambient flicker
    GPIO33=0 is TRACK, confirmed shaded and agreeing with the TMUX1219 truth table.
    Level 0 read +22.8 / +19.1 mV across two repeats - consistent and near zero, as a
    node DC-coupled to ground through R96 2M must be. Level 1 read +67.8 / +88.8 mV -
    displaced and still climbing between visits, which is what a floating node doing
    leakage integration looks like. Separation 3.7x. hpf test now writes the result
    into the config.
    WHY THE FIRST TWO RUNS FAILED, AND THE MEASUREMENT THAT CAME OUT OF IT
    Unshaded, the test reported ORDER-DEPENDENT. A capture of ADC5 with the lights on
    and the beam off shows why: 201 codes = 162 mV p-p at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
2026-08-17 hpf test: judge by no-overlap, not by a fixed ratio
    The ratio bar rejected a better measurement than the one it accepted. Three
    shaded runs on the same board, same day, same correct polarity:
    run A L0 = 22.8, 19.1 mV L1 = 67.8, 88.8 mV ratio 3.8 -> CONFIRMED
    run B L0 = 9.1, 8.3 mV L1 = 23.9, 24.3 mV ratio 2.8 -> INCONCLUSIVE
    Run B is by far the cleaner data: its repeats agree to under a millivolt on both
    levels, while run A's HOLD readings differed by 21 mV between visits. The bar
    passed the noisy run and failed the quiet one.
    The mistake was treating the ratio as a property of the board. HOLD is an
    INTEGRATOR - its displacement is the accumulated leakage over however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
2026-08-17 CR-15: LED-to-photodiode crosstalk saturates the TIA above ~2-4 % duty
    Found chasing 313 mV of carrier feedthrough on ADC5 with the beam on. The
    feedthrough was a symptom; the cause is in the front end.
    MEASURED, capture 0x04 at 500 ksps, beam running, no target:
    2 % duty TIA_Out 600 .. 3709 linear
    10 % duty TIA_Out 2 .. 4095 saturated, both rails
    25 % duty TIA_Out 3 .. 4095 saturated, both rails
    Optical rather than electrical, confirmed by the duty scaling: edge-coupled
    pickup would be duty-independent, since the number of switching edges per second
    is identical at any duty. At 2 % the swing is 3109 codes = 2.50 V, so the leakage
    photocurrent is 2.50 V / 470 kOh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
2026-08-17 CR-15: retract the optical conclusion, the mechanism is open
    The user pushed back after a baffle made no difference, and was right to.
    I concluded optical because saturation scales with duty while edge-coupled
    pickup would not. Then, in the next breath, I explained the same duty scaling by
    TIA settling - the light pulse being shorter than the 235 ns feedback time
    constant at low duty. Both explanations cannot stand, and the settling one is
    mechanism-agnostic: an electrically coupled current pulse at the summing node
    would be exactly as wide as the LED on-time and would settle identically. The
    duty sweep therefore shows only that the disturbance is a pulse synchronous with
    the drive, which b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
2026-08-17 Beam drive exonerated: U9 is exact, and my two-events-per-period claim was a miscount
    Saleae capture of GPIO31 and TP5 at 50 MS/s over 21 ms, 210 periods:
    both channels period 100.000 us, sd 1.9 ns
    GPIO31 HIGH 25.000 us
    TP5 LOW 25.06 us (drain node, so low = LED conducting)
    edge counts 210 rising / 210 falling on both
    60 ns of error through the one-shot and no double-pulsing. The drive does
    exactly what it is told.
    This capture only happened because I claimed the earlier ADC2 data showed TWO
    disturbance events per PWM period. It does not. I counted roughly 17 samples of
    4095 between events in a pasted 1000-line column when the true figure is about
    42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
2026-08-17 Bring PROGRESS and BENCH_P3 up to date with the 2026-08-17 bench session
    Several things had gone stale. Section 0 still said Phase 2 next; the phase
    checklist still said Phase 3 bench work had not started; the resume block still
    described the firmware as complete and unrun.
    Now recorded:
    - Phase 3 bench started and what passed: boot, PIO on block 2 at GPIOBASE 16
    confirmed on silicon, threshold DAC against a DMM, static health with adc 2
    reading 2.5884 V against 2.59 expected, hpf test resolving GPIO33 = 0 as
    TRACK in agreement with the TMUX1219 truth table, and cfg save persisting it.
    - Blocked at 3.3 by CR-15. Phase 4 is gated on the same thing, since the
    comparator w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
2026-08-17 Incident resolved: U11B is damaged, U11 needs replacing
    A 10-minute full power removal did not clear it, which rules out a latched
    integrator since C73 is fully discharged by then.
    The closing measurements:
    C73 resistance, power off open not shorted
    R84 / U11.7 = U11B output 0 V negative rail
    R84 / U11.13 = U11D inverting 2.59 V its virtual ground
    R78 far pad = U11D output 5.2 V
    U11D is provably healthy: 2.59 V at its inverting input is the virtual ground a
    working op-amp maintains, and a unity inverter around a 2.59 V reference fed 0 V
    gives 2.59 + 2.59 = 5.18 V, against 5.2 measured.
    U11B is provably broken. Its non-inverting input sits on +2V5 a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
2026-08-18 Add BRINGUP_NEW_BOARD.md, a step-by-step procedure for a second board
    START_HERE covers the case where you have never built or flashed anything.
    Nothing covered the case of a freshly assembled board when the design is already
    understood, which is now the situation - and the answer is not "jump back in
    where we left off". Some things transfer and some do not, and getting that wrong
    is either dangerous or produces measurements that mean nothing.
    The doc opens with that split. Transferable: GPIO33 polarity from the TMUX1219
    truth table, the PWM slice collisions, the PIO GPIOBASE map, Q1 and Q2, the
    netlist-derived corner frequencies, and CR-15's analysis. Per-board: rail
    integrity, the ADC +5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
2026-08-18 beam readback: check against the state that SHOULD hold, not against running
    With the beam off, a healthy board prints two alarming lines:
    funcsel : GPIO31=5 *** NOT PWM *** GPIO39=5 *** NOT PWM ***
    ctr(car) : 930 -> 930 -> 930 *** FROZEN - slice is not running ***
    Both are correct behaviour. funcsel 5 is SIO, and beam.c leaves the pads as
    plain outputs until the beam is commanded on precisely so the carrier cannot
    start at boot. The counter cannot advance while the slice is disabled.
    So the readback shouted in the one state where it should have been silent, and
    the same applies to the PWM_EN line. A diagnostic that cries wolf at idle trains
    the operator to skim past it, which de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
    [cli.c]
2026-08-18 PSU current limit parked VIR at 27 V; document the trap, raise CR-08
    Root cause of two boards reading VIR = 27 V instead of 36 V: the 5.2 V bench
    supply was left at a 0.3 A current limit. VIR's bulk capacitance needs amps for
    a few milliseconds at startup - roughly 100 uF charged to 36 V is 65 mJ - so the
    supply dropped into constant current and the boost never completed soft-start.
    Set to 2 A, both boards now read 36 V.
    What makes this worth writing down is that nothing downstream revealed it. Once
    parked at 27 V the steady draw is tiny, because the 12 V shunt pulls
    (27-12)/4K7 = 3.2 mA instead of 5.1, so the supply sat far below its limit and
    +5V_IN read a healthy 5.207 V. The latch guard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
2026-08-18 CR-15 confirmed on a second board: the saturation is a design property
    Board 2, independently assembled, run through the identical duty sweep with no
    optical baffle:
    2 % 339 - 3672 linear
    3 % 8 - 3680 bottom railed
    4 % 5 - 3775 bottom railed
    6 % 4 - 3981 bottom railed
    8 % 3 - 4095 both rails
    10 % 3 - 4095 both rails
    12 % 4 - 4095 both rails
    25 % 3 - 4095 both rails
    Highest linear duty is 2 % on board 2 against 3 % on board 1 - the same ceiling
    within one measurement step - and the crosstalk swing at 2 % agrees closely at
    2.69 V versus 2.51 V. Board 2 being marginally worse is ordinary unit-to-unit
    variation in LED output, photodiod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
2026-08-18 Record board 2 quiescent TIA_Out: 2.589 V, 2.4 mV p-p
    capture 0x04 400 500000 with the beam off and VIR at 36 V gives 3212-3215, a
    3-code range against a 0.806 mV LSB - the ADC's own noise floor - with a mean of
    2.589 V against the expected 2.59.
    This also closes the adc 2 wander flagged earlier. Those readings (3109, 3200,
    3177, a 91-code spread) were taken between calls seconds apart and with VIR
    parked at 27 V by the current-limited supply. Within a single 0.8 ms window the
    node is steady to a few LSB, so whatever was moving was slow and is now gone. I
    cannot prove the low rail was the cause rather than, say, the room lighting
    changing between readings, but the present state is unambiguo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
2026-08-19 CR-16 and CR-17: the 5 V analog chain vs the 3.3 V ADC, and the missing test point
    CR-16. Every op-amp in the detect chain is an OPA4323 on +5VA, rail-to-rail, so
    outputs swing 0-5.2 V into an ADC whose full scale is 3.3 V. About 36 % of every
    signal is invisible to firmware, and on the TIA monitor it is worse: the node
    idles at 2.59 V with 2.61 V of headroom above and the ADC can see 0.71 V of it.
    It is not a passive limit. Above ~3.6 V the protection diode conducts into +3V3
    through the 1 kOhm series resistor, and 1.6 mA through R27's 33 Ohm droops
    ADC_AVDD by ~53 mV. At a 104 kHz carrier that happens every 9.6 us while the ADC
    samples every 2 us, so the reference is disturbed continuousl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
2026-08-19 CR-15: add a ranked mitigation section
    Four options, ranked, with the framing that orders them: crosstalk and ball
    signal are the same 850 nm light from the same emitter into the same detector,
    so nothing that scales both improves detection - it only moves where the chain
    clips. Options are therefore either ratio fixes or linearity fixes, and only one
    category actually solves the problem.
    1. Aperture or field stop over D12. The only ratio fix, because crosstalk and
    signal differ in DIRECTION rather than wavelength or amplitude - crosstalk is
    near-field leakage from an emitter millimetres away while the ball is at a
    specific distance and angle. Restricting acceptance angle attenuates off-axi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
2026-08-21 CR-15 mechanism confirmed optical, and a large part of it was the operator's hand
    Established with improved baffles: the coupling is overwhelmingly optical. The
    resistor substitution was not needed, so the mitigation ranking applies as
    written and the aperture option is the one that matters.
    The part worth recording is that a hand held in front of the board reflects the
    LED straight back into D12, and that is what made every earlier baffle
    comparison uninterpretable. The no-baffle control moved from 339 to 19 codes at
    2 % duty between sessions with nothing nominally changed, and a hand at a varying
    distance is precisely a variable reflector. Thermal state and ambient light were
    both offered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
2026-08-21 CR-15 mitigated: front end is linear to 25 % duty with baffles and hands clear
    Duty sweep on board 2 with good baffles and the operator clear of the optical
    path:
    2 % 3084 - 3253 169 codes = 136 mV
    4 % 2750 - 3285 535 = 431 mV
    8 % 2373 - 3374 1001 = 807 mV
    12 % 1891 - 3418 1527 = 1231 mV
    25 % 2076 - 3606 1530 = 1233 mV
    No saturation at any duty, no 4095, nothing near the negative rail. Pulse depth
    below the off-level fell from 2.58 V to 0.132 V at 2 %, about 20x.
    Three independent checks that the measurement is sound rather than merely
    convenient. The servo signature tracks the model: V_off = 2.59 + f x dV predicts
    the rise and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
2026-08-21 Board 2 bring-up complete: hpf test CONFIRMED, Phase 3 unblocked
    hpf test on board 2 returns CONFIRMED, GPIO33=0 is TRACK, matching the
    compiled HPF_SEL_TRACK. Third independent confirmation. The result is
    clean in a way the earlier failures were not: the two visits to a level
    agree to 0.1 and 0.2 mV against 17.8 mV between levels, so order_effect
    is false by ~100x. Earlier ORDER-DEPENDENT runs were 1.2x and 1.4x.
    Closes F6, open since planning. HOLD leakage on board 2 is ~52 pA
    (<=2.3 mV/s at ADC5) vs board 1's ~250 pA. At that rate the baseline
    takes ~43 s to walk 100 mV while a ball transit is 1-10 ms, so the
    worry that ARMED could not be held open was wrong by 3-4 orders of
    magnitude. B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
    [detect.h]
2026-08-21 Fix inverted GPIO33 polarity in BENCH_P3_DETECT 3.4 and 3.6b; board 2 thermal
    The polarity correction from 2026-08-17 was applied to the summary table
    at the top of BENCH_P3_DETECT.md but never to the procedures that use
    it. 3.4 Method A said `gpio 33 1` for TRACK and Method B said
    `gpio 33 0` for HOLD -- both backwards -- and 3.6b's rail-step table had
    the same inversion in both rows. Following either as written would have
    run cal demod with the HPF floating and measured the wrong state in the
    test that decides CR-02. Replaced the raw levels with `hpf track` /
    `hpf hold` throughout, which is the one place the constant lives, and
    left the correction visible inline rather than silently editin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
2026-08-21 Lock-in ambient rejection proven at ~48 dB; bursty noise floor found
    Labelled 200 ms captures at 10 ksps, beam on 25 %, TRACK. The 120 Hz
    component is 0.12 mV dark and 0.32 mV lit, against a beam-off baseline
    of 162 mV p-p -- about 250x, ~48 dB. Mains flicker is a solved problem
    and the premise the whole synchronous-detection front end rests on is
    now measured rather than assumed. I had predicted ~64 dB; the shortfall
    is real but the residual is ~7 % of sigma and does not limit anything.
    The quiet-baseline sigma at ADC5 is 0.55-0.65 mV, 3-4x better than the
    2.19 mV taken from the earlier 800 us window -- that window happened to
    land inside a burst, which is exactly the failure mode a 200 ms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
2026-08-21 Burst source: operator motion ruled out, room return is the hypothesis
    Three repeat captures with the operator as far from the beam as
    possible made the bursts WORSE, not better: 52.6 / 43.0 / 19.6 % of
    samples above 20 codes against 20.6 % with them standing at the bench,
    peaking at 77 codes. The motion hypothesis predicted the opposite, so
    it is dead.
    What is reproducible is the quiet floor: sigma 0.61-0.70 mV across all
    five captures now, both lighting conditions, operator near and far.
    sigma(all) is not reproducible at all -- 6.49 to 14.03 mV, a 2x swing
    between captures seconds apart -- so the burst source varies on a
    seconds timescale.
    Checked specifically whether the excursions were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
2026-08-21 Burst source closed: it was the beam returning off the room, not noise
    Covering D11's output aperture, everything else identical, drops sigma
    from 6.49/10.37/14.03 mV to 2.62/3.39/2.91 mV and peaks from 77 to 33
    codes. Excess kurtosis goes from -0.3/-0.3/+3.0 to +0.1/+0.5/+0.1 --
    from wildly non-Gaussian to essentially Gaussian -- and the spread
    between repeats falls from 2x to 30 %. Stop the light leaving the board
    and the bursts stop.
    So the lock-in was passing genuine carrier-modulated light returning
    off the room. That is the detector working correctly, not a fault, and
    the operator standing at the bench had been blocking the return path --
    which is why stepping away made it worse and b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
2026-08-21 cal demod: fix two validity defects that let a saturated sweep commit
    The first cal demod run put 84 % of its 64-point sweep against the ADC
    rail. The response was a square wave, not a cosine: fitted amplitude
    5128 codes against a full scale of 4095 -- impossible for a real signal,
    and exactly what a square gives, since its fundamental is 4A/pi = 1.27A.
    Both guards that should have stopped it failed, in different ways.
    h2_ratio scored 0.012 against a 0.25 bar and passed. Symmetric clipping
    produces only ODD harmonics -- an ideal square wave has h2/h1 = 0
    exactly -- so the even-harmonic purity test was looking in the one place
    clipping is guaranteed to leave no trace. It was not a weak check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
    [cal.c, cal.h, cli.c]
2026-09-17 Add initial rpi5 camera software
2026-09-17 update fingerprint requirement
2026-09-17 Finalize verified Pi 5 dual-camera capture setup
    Include bounded asynchronous disk writers, explicit storage-headroom qualification, installer and device-check fixes, and regression tests. Align setup guides and installer output with the validated IMX296 CAM0 / Mira220 CAM1 configuration.
2026-10-09 Phase 6 strobe: dry tests, live-current mode, host tests, handoff docs
    Strobe firmware (strobe.c, strobe_plan.c, strobe_live.c, strobe_burst.pio):
    the 6a/6b dry-test path (PIO0 burst engine fed by DMA, gate DAC, section 15
    schedule, burst charge interlock, A7 ready-LED fix) and the 6c/6d LIVE mode
    (`strobe live on confirm`): pulses with a setpoint under a staircase limit,
    a 70 % gate ceiling, pacing and a rolling charge budget; ADC0 readback and a
    verdict on every firing (STROBE_OVERCURRENT / STROBE_CLAMP faults end live
    mode with the gate at 0); watchdog armed by the strobe; CLI allowlist while
    live; `strobe cal` and `strobe wave`. Two defects found by independent review
    are fixed and cover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
    [capture-poses.csv]
